nusrobomaster/Dart-FYP/docs/Introduction.md

---
title: 1 Introduction
nav_order: 1
layout: default
permalink: /overview
---

# 1.0 Introduction
### Abstract
This project aims to develop a projectile launcher and projectile to hit targets in the RoboMaster University Championship (RMUC). To do so, ASI - 403 would be building an accurate mock - up of the target for testing, implementing in-flight corrective functionality into the projectile and adjustable pitch & yaw and auto projectile reloading for the launcher. Predictive Maintenance and easy debugging & maintenance is prioritized.
## 1.1 Overview of RoboMaster University Championship (RMUC)

Founded in 2013, DJI RoboMaster University Championship (RMUC) is an annual international robotics competition organized by Da-Jiang Innovations (DJI) in China. Teams would develop different robots to perform combat on the battlefield. 

<br>
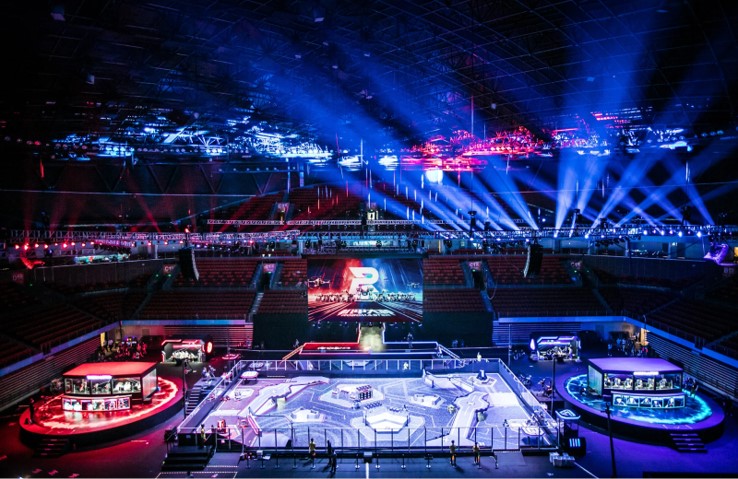
[picture p73: docs/assets/images/vj/Intro-battlefield.jpg]
Battlefield

{: .text-center}
<br>
<p align="center" class="small-text">
<em>Figure 1-1: Front view of the battlefield</em>
</p>
The goal is to launch projectiles at the pressure sensors of opponent robots and targets to defeat them.

## 1.1.1 Targets

<br>
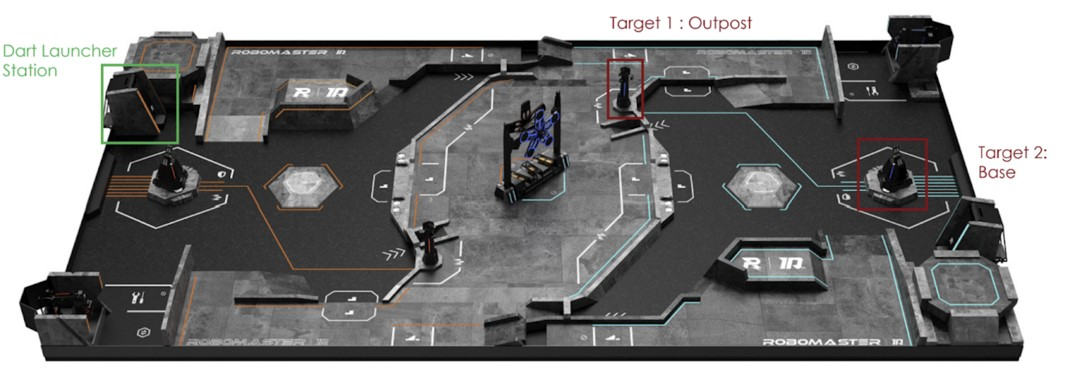
[picture p74: docs/assets/images/vj/Intro-battlefield_targets.jpg]
Battlefield Targets

{: .text-center}
<br>
<p align="center" class="small-text">
<em>Figure 1-2: Battlefield with Labelled Target Locations</em>
</p>

<br>
Target Table
{: .text-center}
<br>
<p align="center" class="small-text">
<em>Table 1-1: Target Pressor Sensor Description</em>
</p>

## 1.1.2 Winning Criteria

<br>
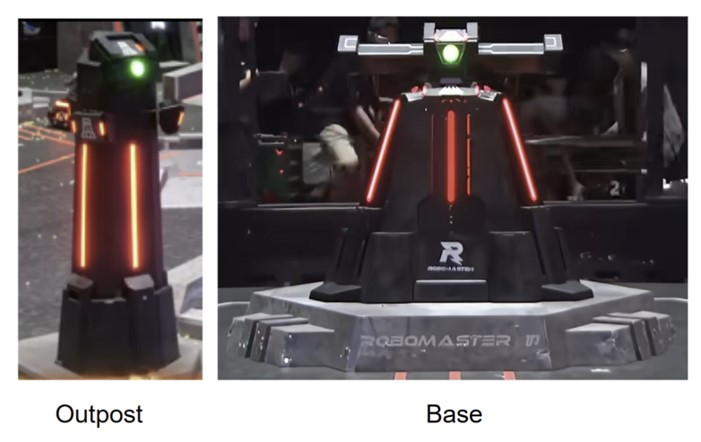
[picture p75: docs/assets/images/vj/Intro-base_outpost.jpg]
Base and outpost

{: .text-center}
<br>
<p align="center" class="small-text">
<em>Figure 1-3: Close up of Targets</em>
</p>
A team wins if the opponent's base HP reaches zero OR its base has more remaining HP than the opponent’s at the end of the match. Base is invincible until outpost is destroyed.

## 1.1.3 Armour Modules

<br>
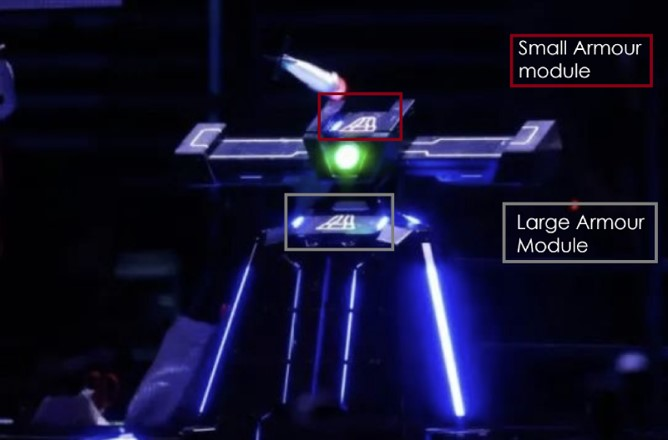
[picture p76: docs/assets/images/vj/Intro-base_armors.jpg]
Base armors

{: .text-center}
<br>
<p align="center" class="small-text">
<em>Figure 1-4: Base with Small and Large Armour Modules</em>
</p>
Most robots and targets, such as Base, use armor modules — official game system components with pressure sensors—to register hits which decreases health.

<br>
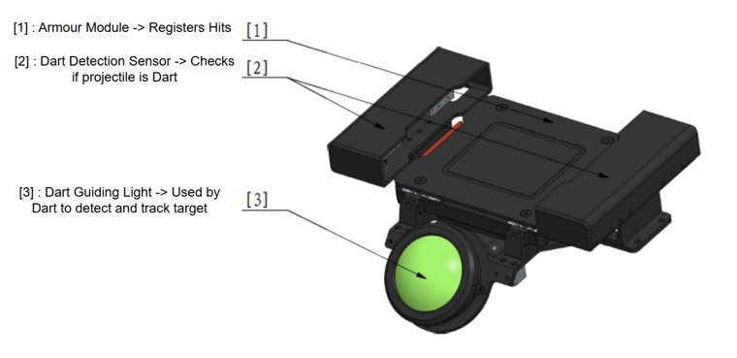
[picture p77: docs/assets/images/vj/Intro-dart_armor.jpg]
armor parts

{: .text-center}
<br>
<p align="center" class="small-text">
<em>Figure 1-5: Close up of Dart Detection Module which is on the Targets (Outpost & Base)</em>
</p>

## 1.1.4 Robot Roles

<br>
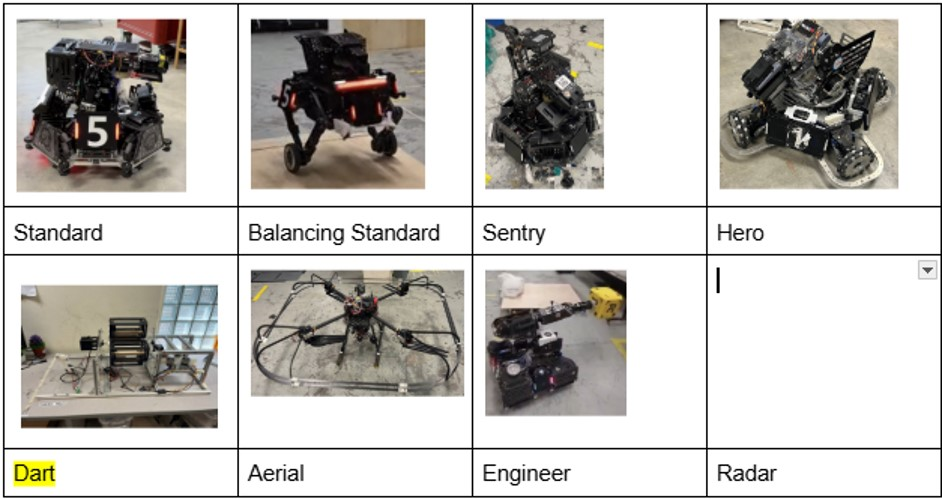
[picture p78: docs/assets/images/vj/Intro-robot_lineup_table.jpg]
Robot lineup Table

{: .text-center}
<br>
<p align="center" class="small-text">
<em>Table 1-2: The current NUS Calibur Robotics robot lineup</em>
</p>
ASI - 403 would be building a new DART robot. (See Appendix 1 for description of other robots.)

## 1.1.5 Launch Window Mechanics

<br>
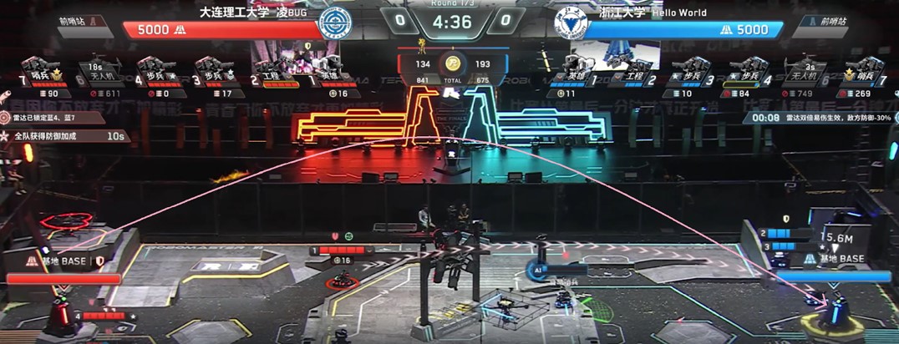
[picture p79: docs/assets/images/vj/Intro-dart_arc.jpg]
Dart flight

{: .text-center}
<br>
<p align="center" class="small-text">
<em>Figure 1-5: Example Projectile Flight Path</em>
</p>
The robot holds up to four projectiles and stays inside the Dart Launching Station with a gate that can open twice per round—once after 30 seconds and again after 4 minutes from the start of the round. Each opening lasts 20 seconds, followed by a 15-second cooldown. Unused openings can be used after the 4 minute mark. [1]

The operator selects which target (Outpost/Base) the Dart Robot aims at each opening. The team wants us to aim at base.(Strategy explained in Appendix 2)

## 1.1.6 Base Targeting Mechanics
Teams can select the desired Base target difficulty. [1]

<br>
<table>
  <tr>
    <th>Difficulty level</th>
    <th>Name of target difficulty</th>
    <th>Description</th>
  </tr>

  <!-- EASY -->
  <tr>
    <td><strong>Easy</strong></td>
    <td>
      <p align="center">
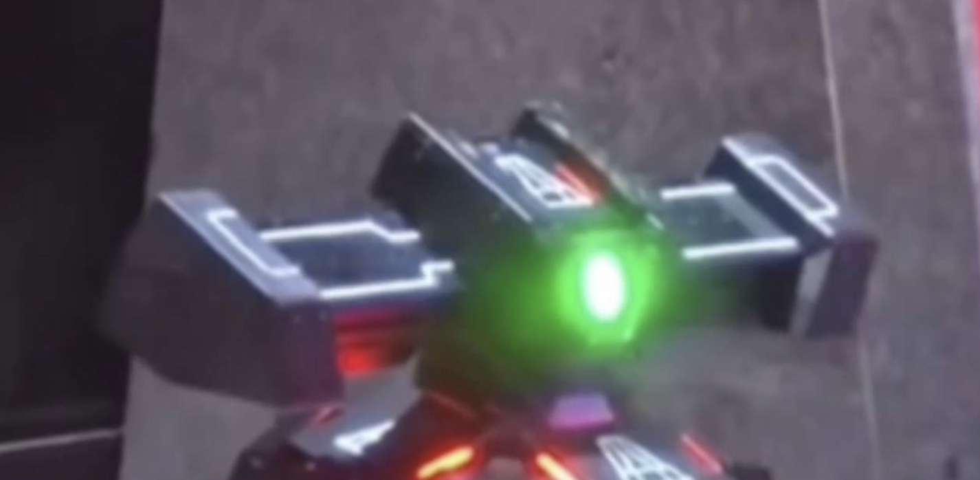
[picture p80: docs/assets/images/vj/Base_Module.png]
        
      </p>
    </td>
    <td>
      Dart Detection Module remains stationary at its initial position.
    </td>
  </tr>

  <!-- MEDIUM -->
  <tr>
    <td><strong>Medium</strong></td>
    <td>
      <iframe width="360" height="215"
      src="https://www.youtube.com/embed/zaj2007g-zE"
      title="YouTube video player"
      frameborder="0"
      allow="accelerometer; autoplay; clipboard-write; encrypted-media; gyroscope; picture-in-picture; web-share"
      allowfullscreen></iframe>
    </td>
    <td>
      Dart Detection Module shifts to a random position before the gate fully opens.
      If a dart hits the target, it moves to a new random location.
    </td>
  </tr>

  <!-- HARD -->
  <tr>
    <td><strong>Hard</strong></td>
    <td>
      <iframe width="360" height="215"
      src="https://www.youtube.com/embed/2M_oOt_SI88"
      title="YouTube video player"
      frameborder="0"
      allow="accelerometer; autoplay; clipboard-write; encrypted-media; gyroscope; picture-in-picture; web-share"
      allowfullscreen></iframe>
    </td>
    <td>
      Dart Detection Module moves continuously as the gate opens.
      After a dart is launched, it relocates within 600 ms to a new random position
      and stays stationary for up to 10 s or until the dart hits.
      Movement range: −280 mm to +280 mm along the field width.
    </td>
  </tr>

</table>

<br>
<p align="center" class="small-text">
<em>Table 1-3: Base Target Difficulty Levels</em>
</p>
Higher difficulty levels increase the damage dealt and debuffs applied to the opponent, while granting greater buffs to the attacking team upon a successful hit. (See Appendix 3 for the damage mechanisms and the buff & debuff mechanisms)

# 1.2 Past attempts’ challenges and our improvements
Since 2022, NUS Calibur Robotics has made several attempts to develop a dart robot and projectile capable of accurately hitting competition targets.
## 1.2.1 Dart Projectile
Earlier designs suffered from unstable flight due to weak aerodynamic choices (Figure 1-6a & 1-6b). This guided our new approach, which focuses on fin geometry, airflow behaviour, and roll control. The projectile will also be upgraded to an active design capable of adjusting its trajectory toward the target.

<br>
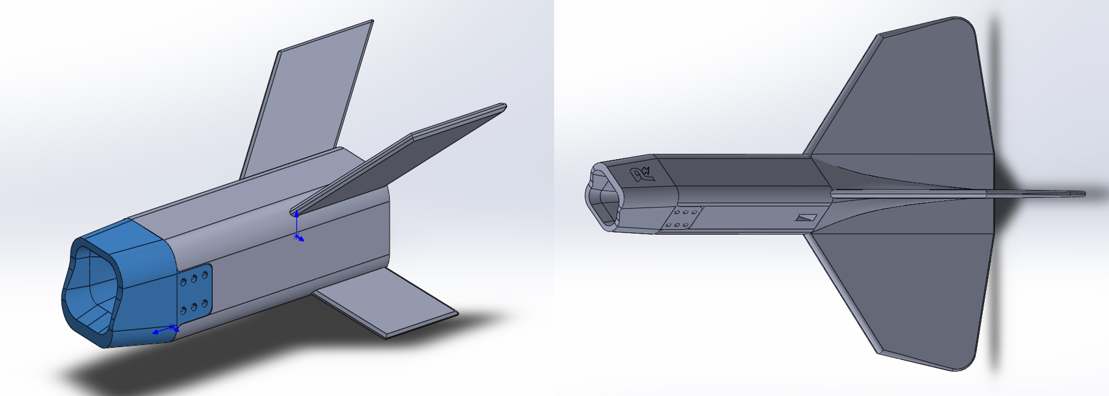
[picture p81: docs/assets/images/jianwen/Intro-past_dart_projectile.jpg]
Past Projectiles

{: .text-center}
<br>
<p align="center" class="small-text">
<em>Figure 1-6a (left) and Figure 1-6b (right): Past attempts at the dart projectile</em>
</p>

## 1.2.2 Dart Robot
Past robots showed unreliable pitch–yaw control, base instability, and inconsistent release (Figure 1-7a & 1-7b). These issues shaped the new design, which prioritizes stable actuation and a stronger frame. The flywheel launcher will be replaced with an elastic band system for more consistent release and improved accuracy.

<br>
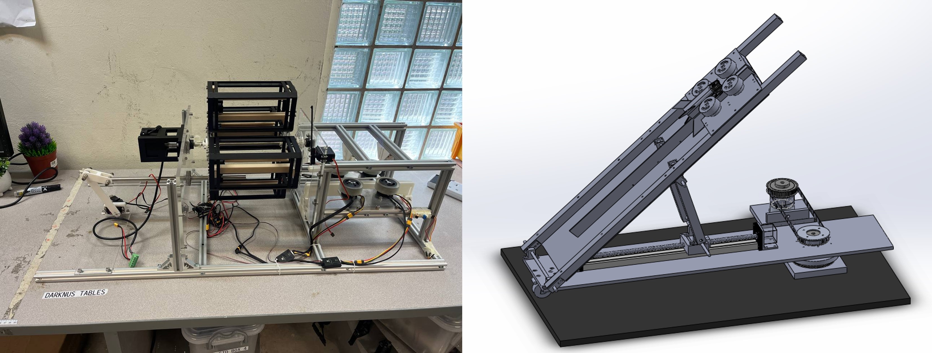
[picture p82: docs/assets/images/jianwen/Intro-past_dart_robot.jpg]
Past Robots

{: .text-center}
<br>
<p align="center" class="small-text">
<em>Figure 1-7a (left) and Figure 1-7b (right): Past attempts at the dart robot</em>
</p>

## 1.2.3 Steps forward
Insights from earlier attempts guide our integrated redesign. The projectile will be developed first, with improved aerodynamics and active-flight components. The robot will follow with reliable pitch–yaw control, a stable frame, and a simplified launch mechanism to support accurate, repeatable shots.

# 1.3 Value proposition
## 1.3.1 Stakeholders
### NUS Calibur Robotics
The goal of NUS Calibur Robotics is to compete in RMUC, which marks as a significant step up from previous years where the team only participated in the RoboMaster University League (RMUL), a smaller competition with fewer requirements. This aspiration is strongly encouraged by one of the team’s main sponsor, who views RMUC participation as an important milestone and a natural progression for NUS Calibur Robotics. With the discontinuation of the affiliation between RMUL and DJI, the motivation to advance to RMUC has become even stronger. Although the dart system is not a mandatory requirement for entry, its absence was one of the key factors that limited the team’s eligibility for RMUC 2025. As eligibility is bell-curved across all teams, producing a functional dart prototype by March next year is therefore crucial to demonstrate the team’s technical capability and readiness for RMUC qualification.
### Robomaster Organization Community (DJI RMOC) 
The RoboMaster Organizing Committee (RMOC), founded by DJI, is the governing body that oversees the RoboMaster competitions. RMOC establishes and updates the rule manual, building specifications, and technical assessment criteria for all participating teams to ensure fair, transparent, and competitive gameplay. The rule manual outlines the competition gameplay, including game objectives, field layout, and damage scoring. While the building specifications provide guidelines for robot design, setting limits on dimensions, weight, and power. Lastly, the assessment criteria is used to filter for teams with the best technical competency.
## 1.3.2 Value Proposition Canvas
With the stakeholders identified and NUS calibur robotics chosen as our main stakeholder, a value proposition canvas was done below in Figure 1-8.

<br>
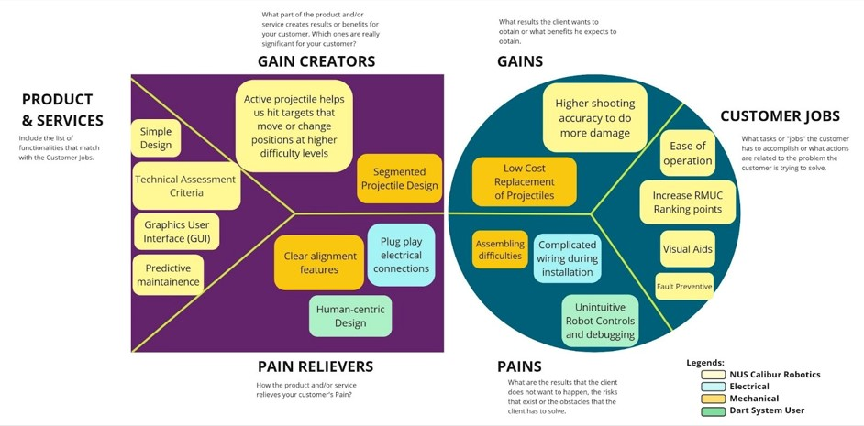
[picture p83: docs/assets/images/barry/Intro-value_prop.jpg]
Value prop canvas

{: .text-center}
<br>
<p align="center" class="small-text">
<em>Figure 1-8: Value Proposition Canvas</em>
</p>
After drafting the value proposition canvas, our value proposition statement is formulated from the value proposition canvas.

## 1.3.3 Value Proposition Statement
Our team aims to help **NUS Calibur Robotics** build a simple and accurate dart system through clear alignment features with plug-and-play electrical connections and active projectiles able to hit the target at all difficulty levels.

This dart system will also be competition-ready, which is to comply with the rules and regulations set by the **RMOC**.

The dart system will abide by the technical assessment criteria set by **RMOC** and provide **NUS Calibur Robotics** with additional ranking points.

# 1.4 DESIGN SPECIFICATION
We have two key stakeholders with different requirements that our DART project will have to satisfy, DJI RMOC committee who organise this competition and set the rules and regulations, and NUS Calibur Robotics who will be using our Dart Robot in its entirety after our project ends. Firstly, from the Robomaster Organization Community (DJI RMOC) standpoint, here are the requirements:

## RMOC Standpoint Requirements:
## 1.4.1 Arena Setup

<br>
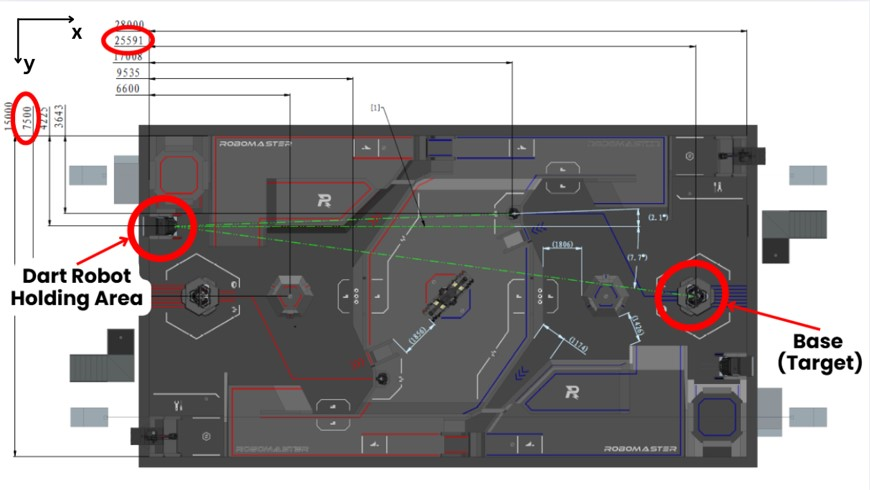
[picture p84: docs/assets/images/shyam/Intro-targets1.jpg]
Map target 1

{: .text-center}
<br>
<br>
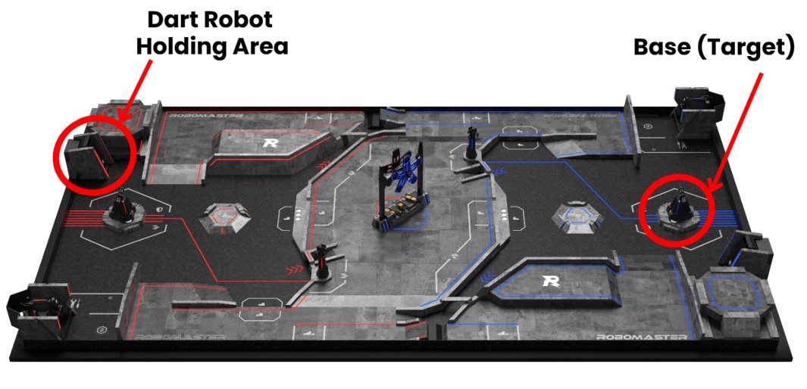
[picture p85: docs/assets/images/shyam/Intro-targets2.jpg]
Map target 2

{: .text-center}
<br>
<p align="center" class="small-text">
<em>Figure 1-9 & 1-10: Complete Arena Setup with dimensions specified</em>
</p>

1. The backend of the Dart System will be positioned exactly x-distance 25591mm away from the target, and has to turn 7.7 degrees to the right in order to align with the center mark of the target plate. The y-distance is exactly 3275mm. 

<br>
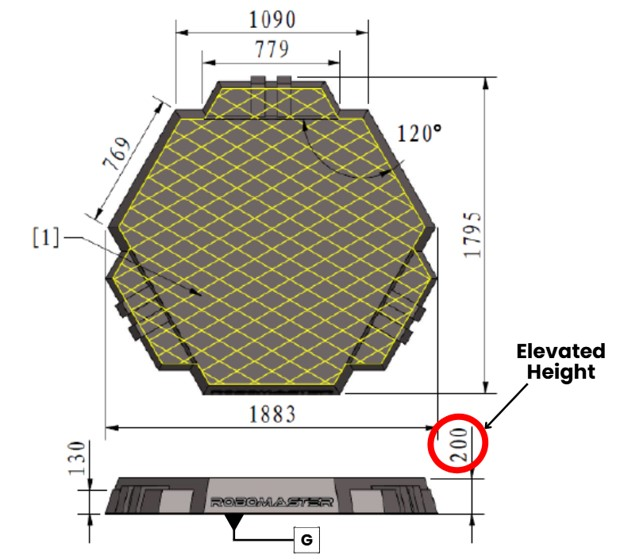
[picture p86: docs/assets/images/shyam/Intro-platform_specs.jpg]
Platform specs

{: .text-center}
<br>
<p align="center" class="small-text">
<em>Figure 1-11: Base Target structure’s platform</em>
</p>

2. The entire base target structure sits on a platform that is elevated off common ground by 200mm. This key information is vital to add to the dimensions highlighted in Figure 1-12, and these values are key for the launcher calculations in accurately hitting the target.

<br>
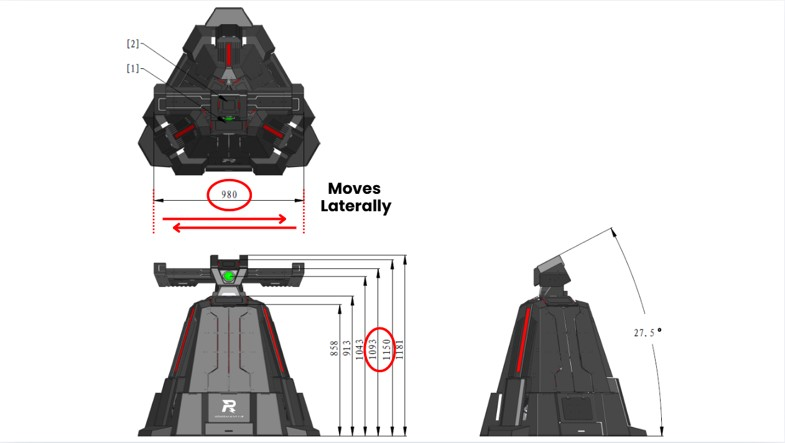
[picture p87: docs/assets/images/shyam/Intro-base_specs.jpg]
Base Specs

{: .text-center}
<br>
<p align="center" class="small-text">
<em>Figure 1-12 & 1-13: Base Target Structure </em>
</p>

3. The target plate is able to move laterally a distance of 980mm. Target is a small armour plate (square shape, 140mmx140mm) tilted 27.5 degrees from the horizontal plane. ***From a vertical standpoint***, the allowable range for a successful hit is y∈{1293mm,1350mm}. For accuracy, let us aim for bullseye, **y=1321.5mm**.

<br>
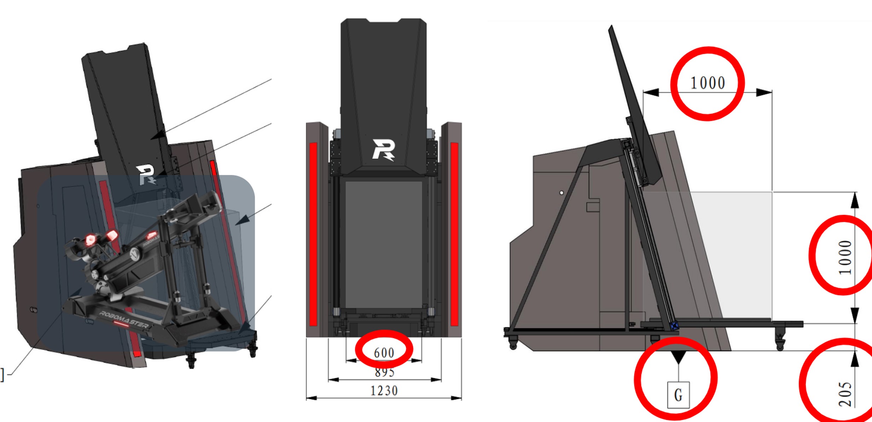
[picture p88: docs/assets/images/shyam/Intro-gate_specs.jpg]
gate specs

{: .text-center}
<br>
<p align="center" class="small-text">
<em>Figure 1-14: Dart Robot Holding Station</em>
</p>

4. The Dart Robot will be placed inside the Dart Robot Holding Station shown in Figure 1-14 prior to the match, and hence must abide by the Size restriction 1000mmx600mmx1000mm (LxBxH).Keep in mind the dart system is placed on the sliding platform that is 205mm elevated from common ground.

## 1.4.2 ROBOT BUILDING SETUP

**Dart System Regulations:**
The Dart Robot consists of the Yaw, Pitch, Launcher and Feeder. The Launcher and Feeder combined can hold *no more than 4 projectiles* prior to the match, and it *may or have ONE projectile pre-loaded before the match*. The Dart Robot serves as the carrier of projectiles and provides them with initial propulsion.

<br>
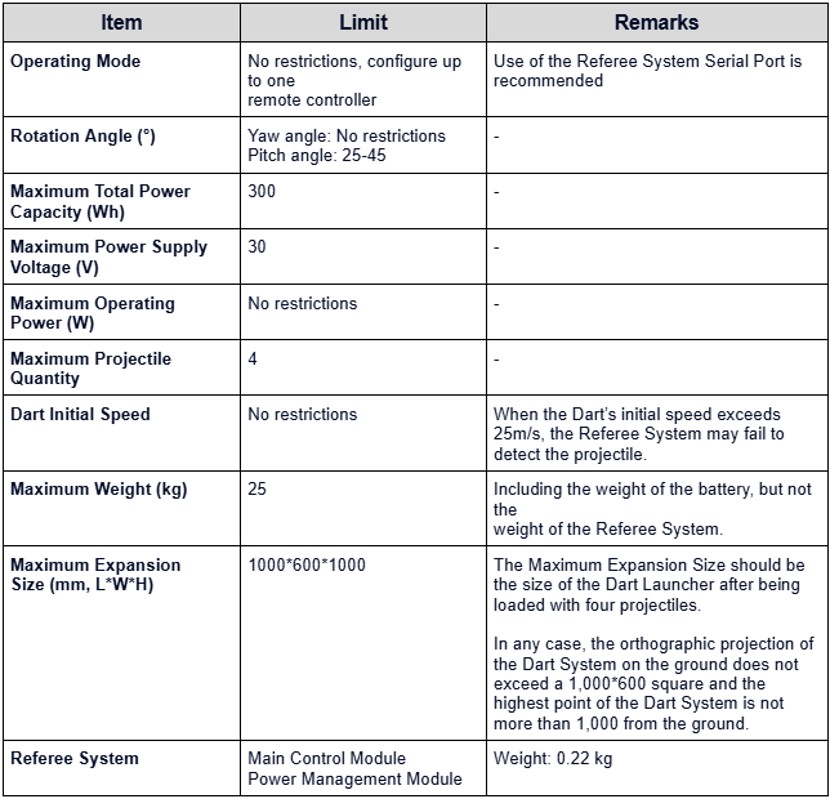
[picture p89: docs/assets/images/shyam/Intro-robot_specs_table.jpg]
dart robot specs table

{: .text-center}
<br>
<p align="center" class="small-text">
<em>Table 1-4: Dart System Production Parameters</em>
</p>

**Projectile Regulations:**

<br>
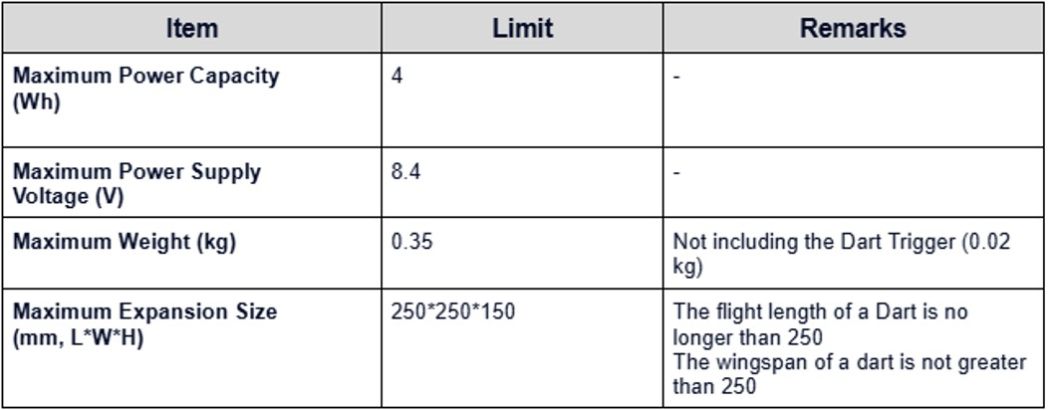
[picture p90: docs/assets/images/shyam/Intro-dart_proj_specs_table.jpg]
projectile specs table

{: .text-center}
<br>
<p align="center" class="small-text">
<em>Table 1-5: Projectile Production Parameters</em>
</p>

<br>
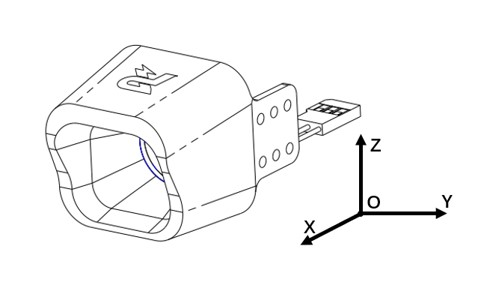
[picture p91: docs/assets/images/shyam/Intro-proj_head.jpg]
dart trigger

{: .text-center}
<br>
<p align="center" class="small-text">
<em>Figure 1-15: Mandatory Dart Trigger at the head of projectile</em>
</p>

The Dart Trigger designated by the RMOC will be mounted on our custom Projectile. This is a competition requirement and cannot be changed or modified. The Dart Trigger is a cream-white translucent shell made of TPU, with a mass of 20 g. Its external form is shown above.

After the Dart Trigger is mounted, ensure its top, bottom, left, and right sides are not blocked by the projectile structure. Within a hemisphere of a 125 mm radius centered on the central point of the bottom surface of the Dart Trigger, there must be no blockage, as shown in the figure below.

<br>
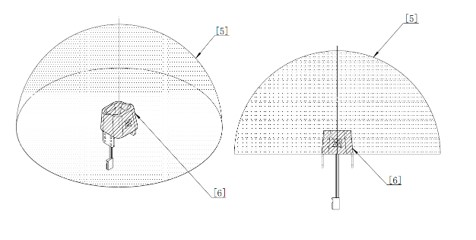
[picture p92: docs/assets/images/shyam/Intro-proj_head_restrict.jpg]
dart trigger restrictions

{: .text-center}
<br>
<p align="center" class="small-text">
<em>Figure 1-16: Dart Projectile Rules regarding Dart Trigger (no blockage surrounding dart trigger) </em>
</p>
Dart cameras or other devices can be mounted in the internal cavity of Dart Trigger. The mounting area shall not exceed the shadow area, as shown below.

<br>
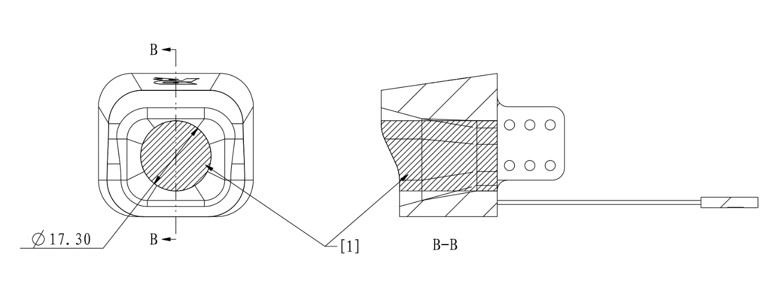
[picture p93: docs/assets/images/shyam/Intro-proj_head_specs.jpg]
dart trigger specs

{: .text-center}
<br>
<p align="center" class="small-text">
<em>Figure 1-17: Dart Projectile Rules regarding Dart Trigger (usage of inner hollow space)</em>
</p>

## 1.5 Design Approach

<br>
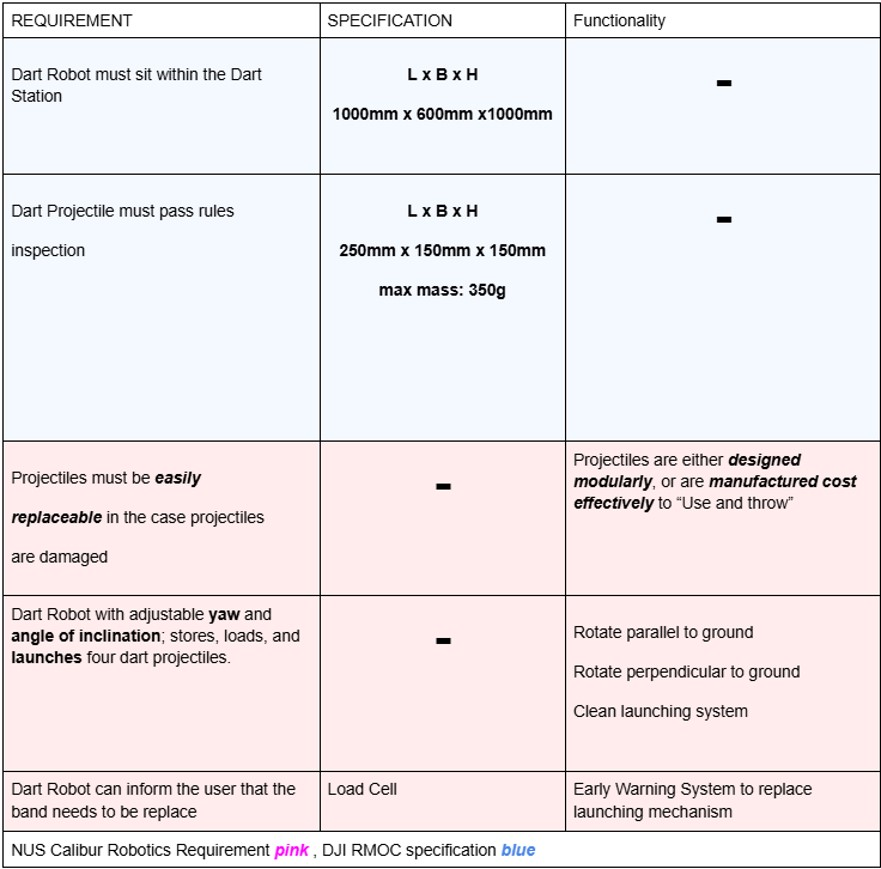
[picture p94: docs/assets/images/shyam/Intro-functionality_table.jpg]
functionality table

{: .text-center}
<br>
<p align="center" class="small-text">
<em>Table 1-6: Functionality Table of entire Dart Robot</em>
</p>
Our team has compiled both the requirements from NUS Calibur Robotics and DJI RMOC’s rules and have formatted them into a functionality table in Table 1-6. This table clearly pins down the requirements into their respective specifications that we will have to adhere to, and more importantly the Functionalities we will have to deliver.
