nusrobomaster/Dart-FYP/docs/References.md

---
title: 11 References
nav_order: 99
layout: default
permalink: /References
---

<!-- Short overview of the projectile here -->

### References

| Ref | Full IEEE Reference |
|-----|---|
| **[1]** | RoboMaster Organizing Committee, *RoboMaster 2025 University Championship Rules Manual*, Version 2.0.0, July. 3, 2025. |
| **[2]** | “Complete Guide to LiPo Battery Voltage,” Ufine Battery [Official], 2024.|
| **[3]** | RoboticsTomorrow, “Optimizing Servo System Performance: A Comprehensive Guide to Eliminating Electrical Noise and Enhancing Noise Immunity” Roboticstomorrow.com, 2024.|
| **[4]** | L. OpenMV, “Creating threshold for color blob tracking,” OpenMV Forums, May 26, 2018. (accessed Nov. 16, 2025). |
| **[5]** | RoboMaster Organizing Committee, *Robot Building Specifications Manual*, Version 1.2.0, Apr. 9, 2025. |
| **[6]** | DJI, *RoboMaster Development Board User Manual*, Access PDF, 2025. |

‌
