nusrobomaster/Dart-FYP/docs/Z Dart Robot.md

---
title: Dart Robot
parent: Dart System
has_children: true
nav_order: 2
layout: default
permalink: /dart-system/dart-robot
has_toc: false
---

<!-- overview of the dart robot -->
# Dart Robot Section

<br>
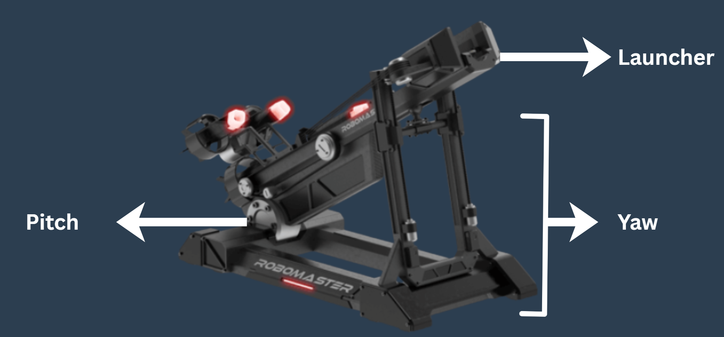
[picture p143: docs/assets/images/shyam/pyl.png]
pyl

{: .text-center}
<br>
<p align="center" class="small-text">
<em>3D rendering of Yaw, Pitch and Launcher</em>
</p>

<h3> Mechanical - Dart Robot </h3>
<h3>
<a href="{{ '/dart-system/dart-robot/yaw' | relative_url }}">Yaw</a><br>
<a href="{{ '/dart-system/dart-robot/pitch' | relative_url }}">Pitch</a><br>
<a href="{{ '/dart-system/dart-robot/launcher' | relative_url }}">Launcher</a>
</h3>
This section lists the mechanical subsystems of the Dart Robot: Yaw, Pitch, and Launcher.

<h3>
<a href="{{ '/dart-system/dart-robot/elec-software' | relative_url }}">Electrical & Software - Dart Robot</a>
</h3>
This section lists the electrical and software work of the Dart Robot, covering sensing, control logic, and actuation.
