nusrobomaster/Dart-FYP/docs/Project Plan.md

---
title: 9 Project Plan
nav_order: 4
layout: default
permalink: /project_plan
---

# Project Plan
The Gantt chart in Figure 9-1 outlines the subsystem tasks from 4 August 2025 to 31 July 2026. Key milestones are marked with red boxes and a red star. The main milestone is the handover of the robot to the competition team, followed by the competition date two months later. 

<br>
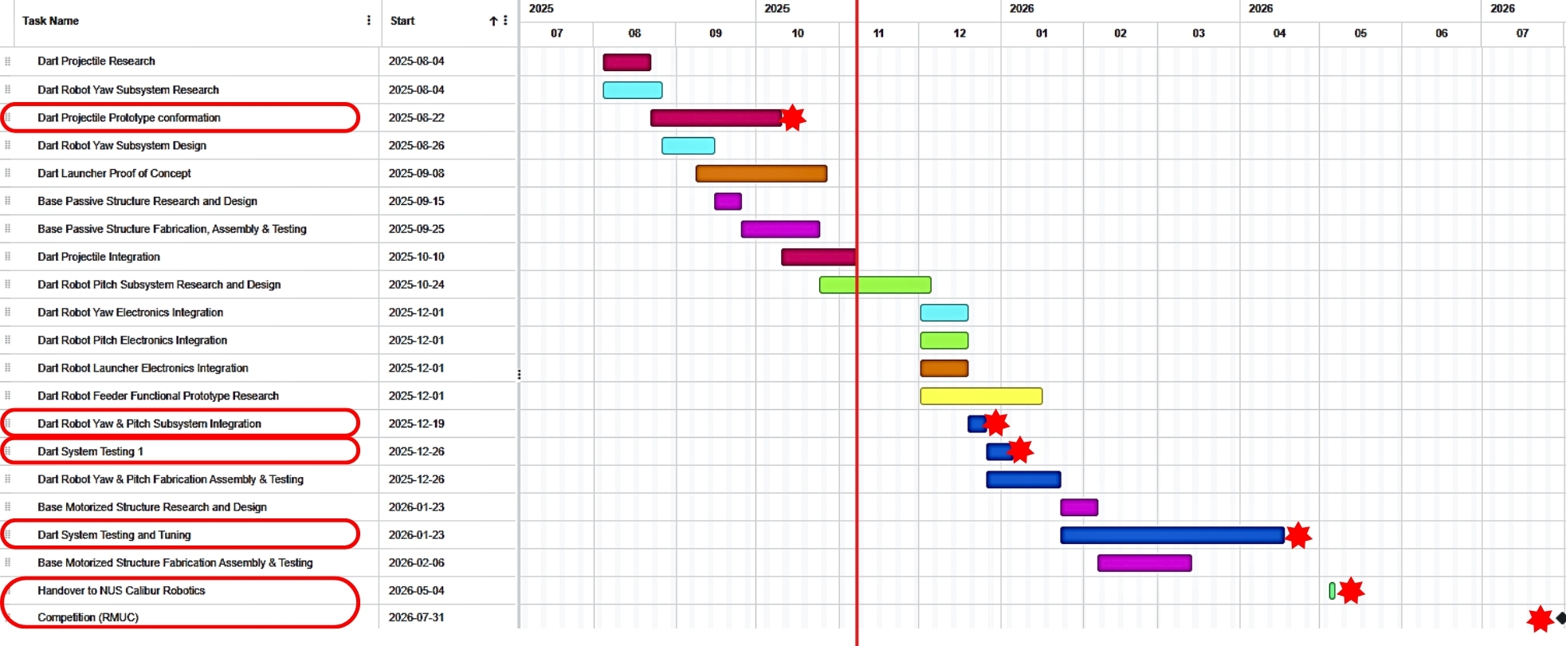
[picture p144: docs/assets/images/jianwen/Project_plan-gantt.jpg]
gantt chart

{: .text-center}
<br>
<p align="center" class="small-text">
<em>Figure 9-1: Gantt Chart detailing project activities</em>
</p>
