nusrobomaster/Dart-FYP/docs/Z Dart System.md

---
title: Dart System
nav_order: 2        # between Introduction (1) and Base Structure (3/4)
has_children: true
layout: default
permalink: /dart-system
has_toc: false
---

<!-- intro text -->
# Our Robot Subsystems
From the functionality table, we derived the following subsystems labelled in the rendering below.

<br>
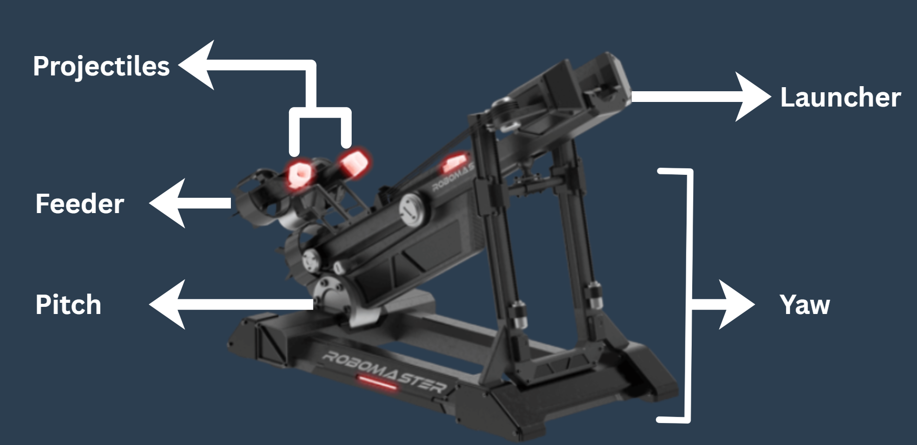
[picture p145: docs/assets/images/shyam/robotsubdiv.png]
full dart subsys

{: .text-center}
<br>
<p align="center" class="small-text">
<em>A 3D rendering of a Dart Robot designed by RMOC.</em>
</p>

# The Team

Below are the personnel in our project team, and the breakdown of responsibilities for each subsystem.

<div class="team-grid">

  <div class="team-card">
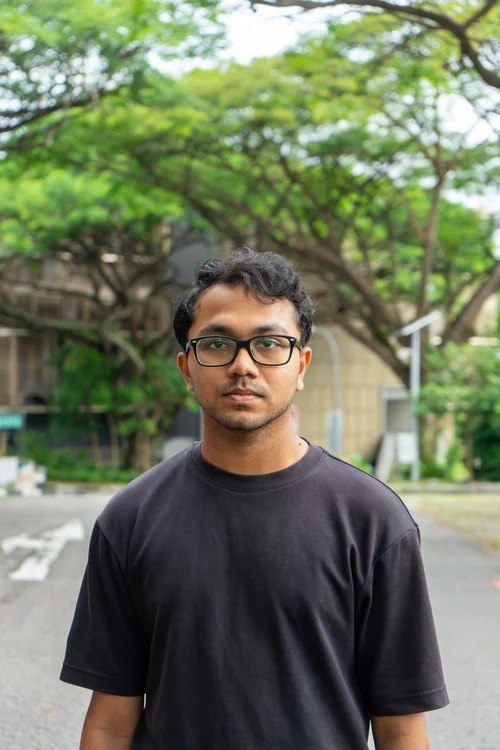
[picture p146: docs/assets/images/portraits/VJ-portrait.jpg]
VJ
    
    <p class="team-meta">VJ<br>A0261513N<br>Electrical</p>
    <p class="team-name">
      <a href="{{ '/dart-system/projectile/elec-software' | relative_url }}">Projectile - Electrical & Software</a><br>
      <a href="{{ '/base_structure' | relative_url }}">Base Structure</a>
    </p>
  </div>

  <div class="team-card">
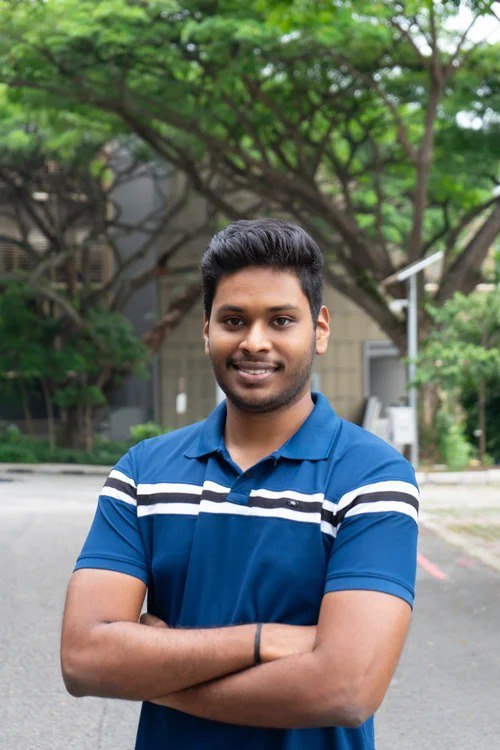
[picture p147: docs/assets/images/portraits/Shyam-portrait.jpg]
Shyam
    
    <p class="team-meta">Shyam<br>A0251760J<br>Mechanical</p>
    <p class="team-name">
      <a href="{{ '/dart-system/projectile/mechanical' | relative_url }}">Projectile - Mechanical Design</a><br>
      <a href="{{ '/dart-system/dart-robot/launcher' | relative_url }}">Launcher - Mechanical Design</a>
    </p>
  </div>

  <div class="team-card">
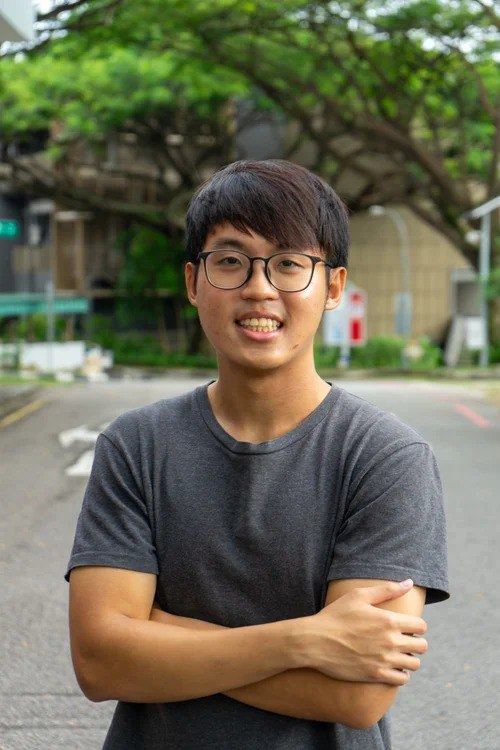
[picture p148: docs/assets/images/portraits/Barry-portrait.jpg]
Barry
    
    <p class="team-meta">Barry<br>A0258254Y<br>Electrical</p>
    <p class="team-name">
      <a href="{{ '/dart-system/dart-robot/elec-software' | relative_url }}">Dart Robot - Electrical & Software</a>
    </p>
  </div>

  <div class="team-card">
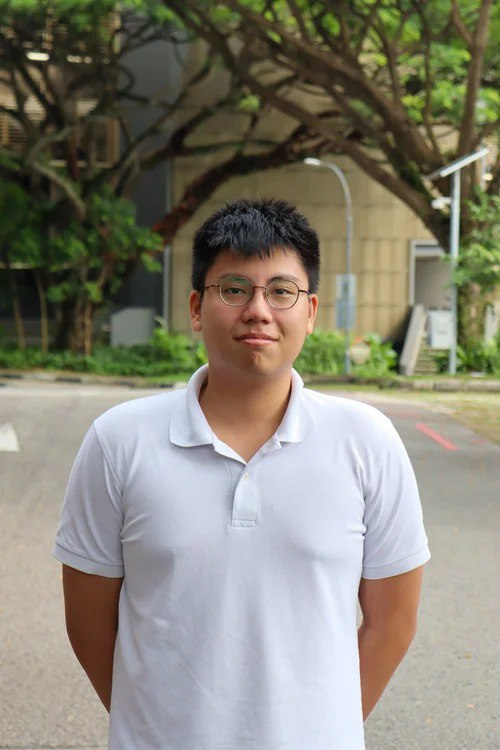
[picture p149: docs/assets/images/portraits/Jianwen-portrait.jpg]
Jian Wen
    
    <p class="team-meta">Jian Wen<br>A0252100E<br>Mechanical</p>
    <p class="team-name">
      <a href="{{ '/dart-system/dart-robot/yaw' | relative_url }}">Yaw - Mechanical Design</a><br>
      <a href="{{ '/dart-system/dart-robot/pitch' | relative_url }}">Pitch - Mechanical Design</a><br>
      <a href="{{ '/base_structure' | relative_url }}">Base Structure</a>
    </p>
  </div>

</div>
