nusrobomaster/Dart-FYP/docs/Z Projectile.md

---
title: Projectile
parent: Dart System
has_children: true
nav_order: 1
layout: default
permalink: /dart-system/projectile
has_toc: false
---

<!-- Short overview of the projectile here -->
# Dart Projectile Section

<br>
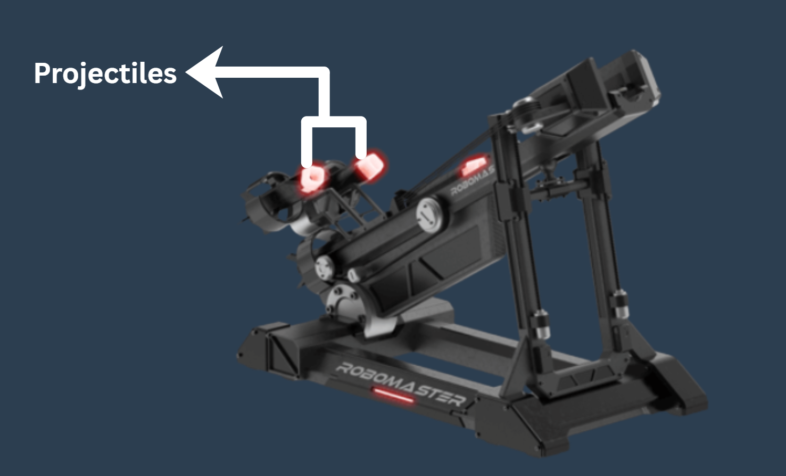
[picture p150: docs/assets/images/shyam/ponly.png]
ponly

{: .text-center}
<br>
<p align="center" class="small-text">
<em>3D rendering showing the Projectiles</em>
</p>

<h3>
<a href="{{ '/dart-system/projectile/mechanical' | relative_url }}">Mechanical - Projectile</a>
</h3>

This section lists the mechanical aspects of the Projectile, such as structure, aerodynamics, and testing.

<h3>
<a href="{{ '/dart-system/projectile/elec-software' | relative_url }}">Electrical & Software - Projectile</a>
</h3>

This section lists the electrical work related to the Projectile, including sensors, triggering, and data capture.
