nusrobomaster/Dart-FYP/docs/index.md

---
layout: default
title: Home
nav_order: 0
nav_exclude: true
---
<!-- useless fking page<-->
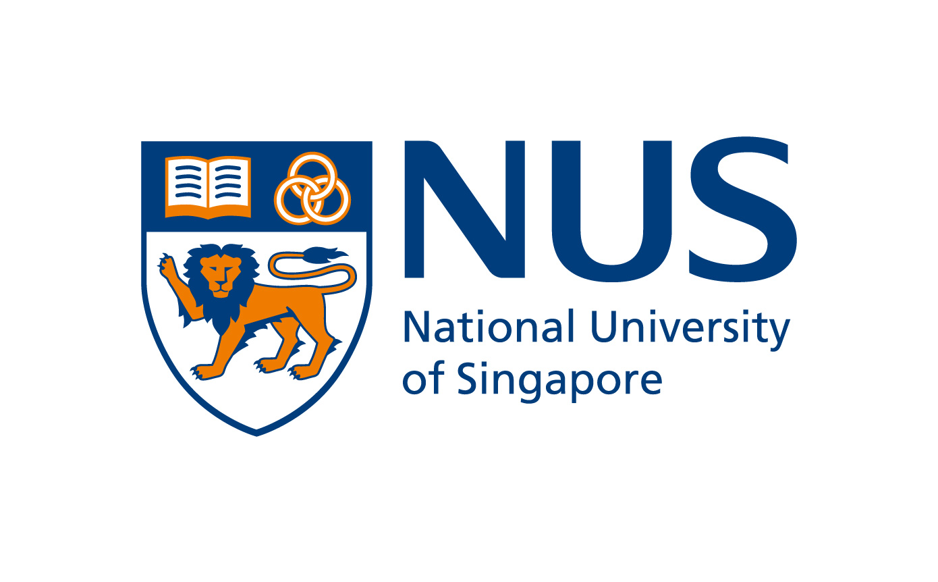
[picture p151: docs/assets/images/portraits/NUS_Logo.jpg]
NUS Logo

{: .text-center}
<br>

<h2 align="center"> CDE 4301: ASI-403 Dart Project Interim Report </h2>
<h2 align="center"> To Begin, Click on 1 Introduction from the Navigation Bar on your left </h2>
