nusrobomaster/Dart-FYP/docs/Dart Robot Subsystems.md

---
title: Dart Robot Subsystems
has_children: true
nav_order: 2
layout: default
permalink: /dart_robot_subsystems
has_toc: true
nav_exclude: true
---
# The Team

Below is the breakdown of responsibilities for each subsystem.

<div class="team-grid">

  <div class="team-card">
    VJ
    <p class="team-meta">VJ<br>A0261513N<br>Electrical</p>
    <p class="team-name">
      <a href="{{ '/projectile/elec&software' | relative_url }}">Projectile - Electrical & Software</a><br>
      <a href="{{ '/base_structure' | relative_url }}">Base Structure</a>
    </p>
  </div>

  <div class="team-card">
    Shyam
    <p class="team-meta">Shyam<br>A0251760J<br>Mechanical</p>
    <p class="team-name">
      <a href="{{ '/projectile/mech_design' | relative_url }}">Projectile - Mechanical Design</a><br>
      <a href="{{ '/launcher/mech_design' | relative_url }}">Launcher - Mechanical Design</a>
    </p>
  </div>

  <div class="team-card">
    Barry
    <p class="team-meta">Barry<br>A0258254Y<br>Electrical</p>
    <p class="team-name">
      <a href="{{ '/launcher/elec&software' | relative_url }}">Launcher - Electrical & Software</a>
    </p>
  </div>

  <div class="team-card">
    Jian Wen
    <p class="team-meta">Jian Wen<br>A0252100E<br>Mechanical</p>
    <p class="team-name">
      <a href="{{ '/yaw' | relative_url }}">Yaw - Mechanical Design</a><br>
      <a href="{{ '/pitch' | relative_url }}">Pitch - Mechanical Design</a><br>
      <a href="{{ '/base_structure' | relative_url }}">Base Structure</a>
    </p>
  </div>

</div>
