nusrobomaster/Dart-FYP/docs/assets/images/barry/GUI_Library_Comparison.png

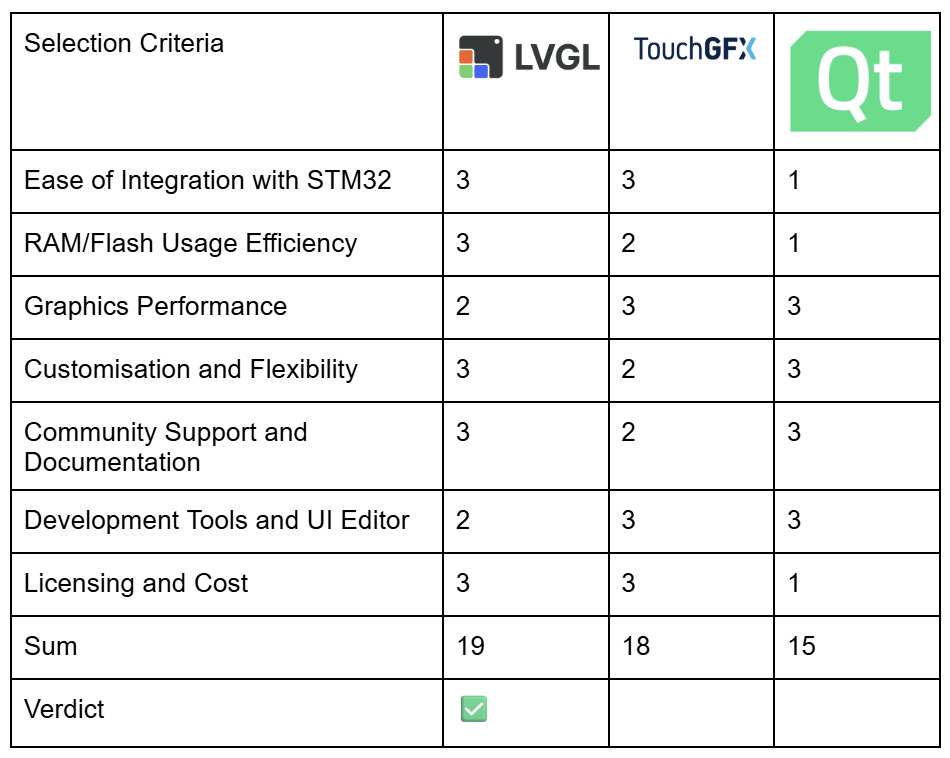
docs/assets/images/barry/GUI_Library_Comparison.png
