nusrobomaster/Dart-FYP/docs/assets/images/barry/Touch_Screen_Comparison.png

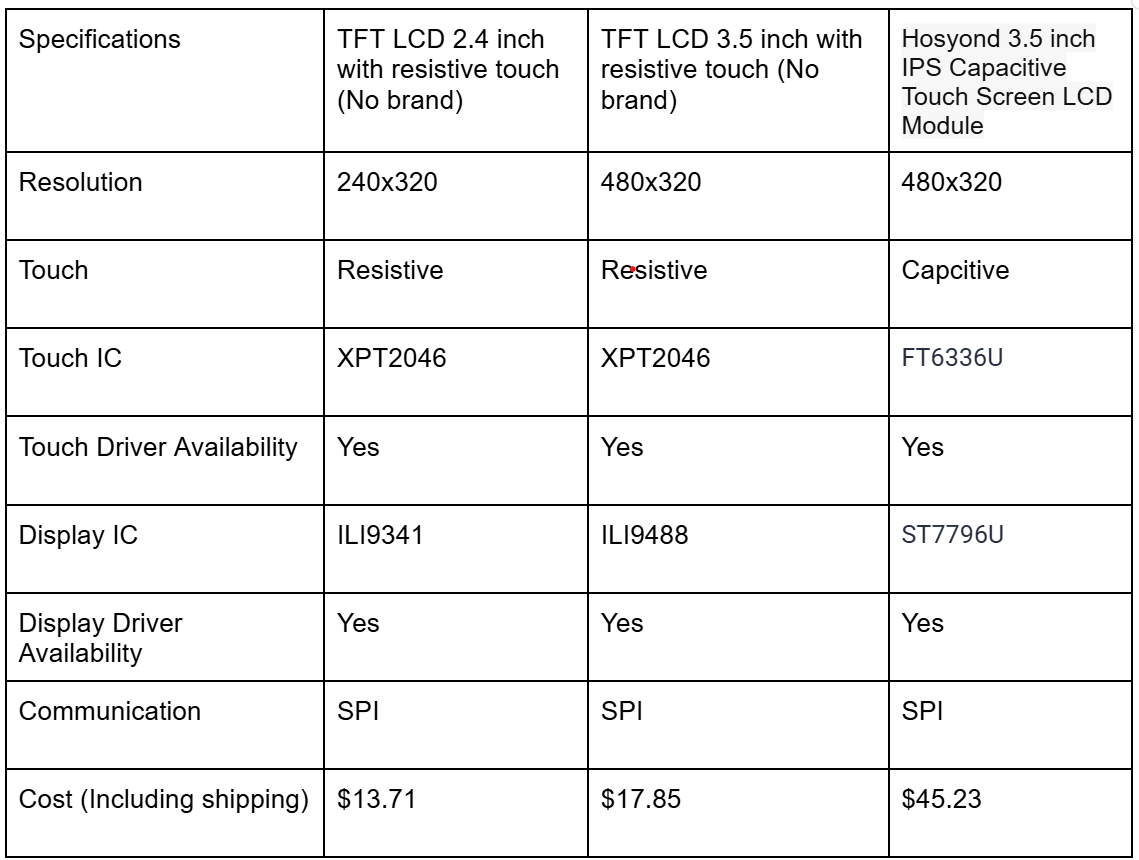
docs/assets/images/barry/Touch_Screen_Comparison.png
