nusrobomaster/Dart-FYP/docs/assets/images/shyam/compression.png

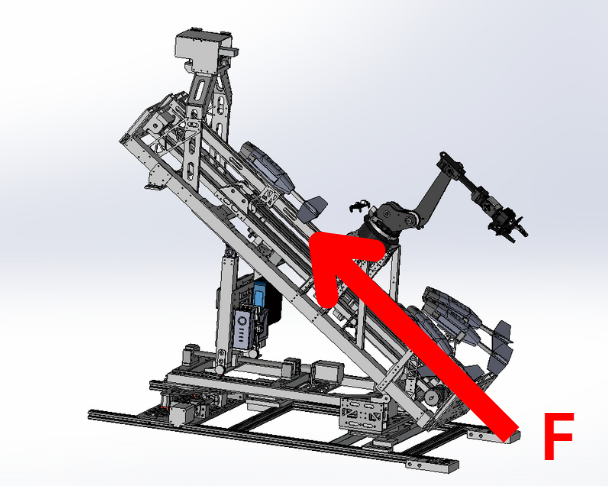
docs/assets/images/shyam/compression.png
