nusrobomaster/Dart-FYP/docs/assets/images/shyam/Intro-armor_specs.jpg

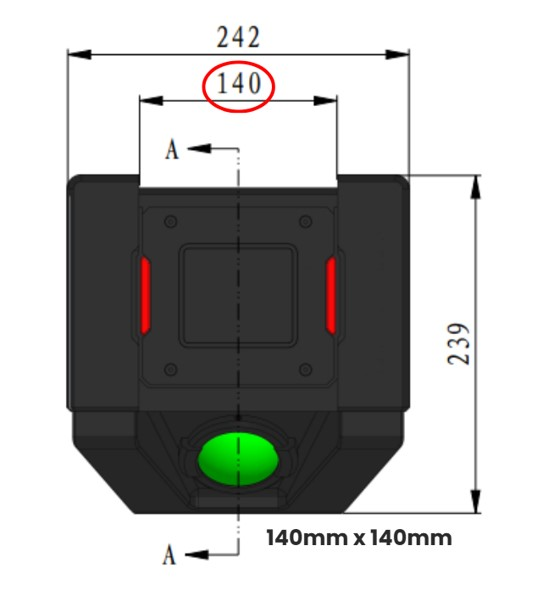
docs/assets/images/shyam/Intro-armor_specs.jpg
