nusrobomaster/Dart-FYP/docs/assets/images/shyam/launcherreal.png

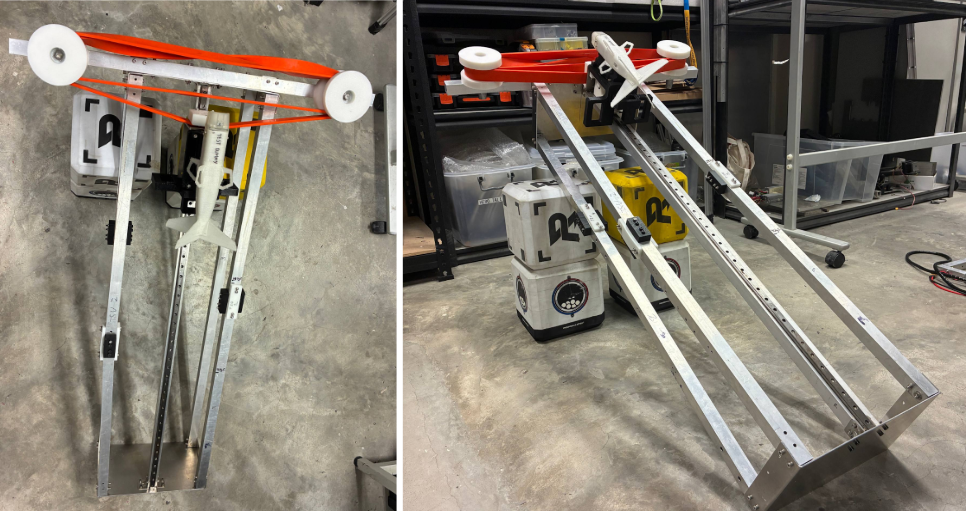
docs/assets/images/shyam/launcherreal.png
