nusrobomaster/Dart-FYP/docs/assets/images/shyam/spring.png

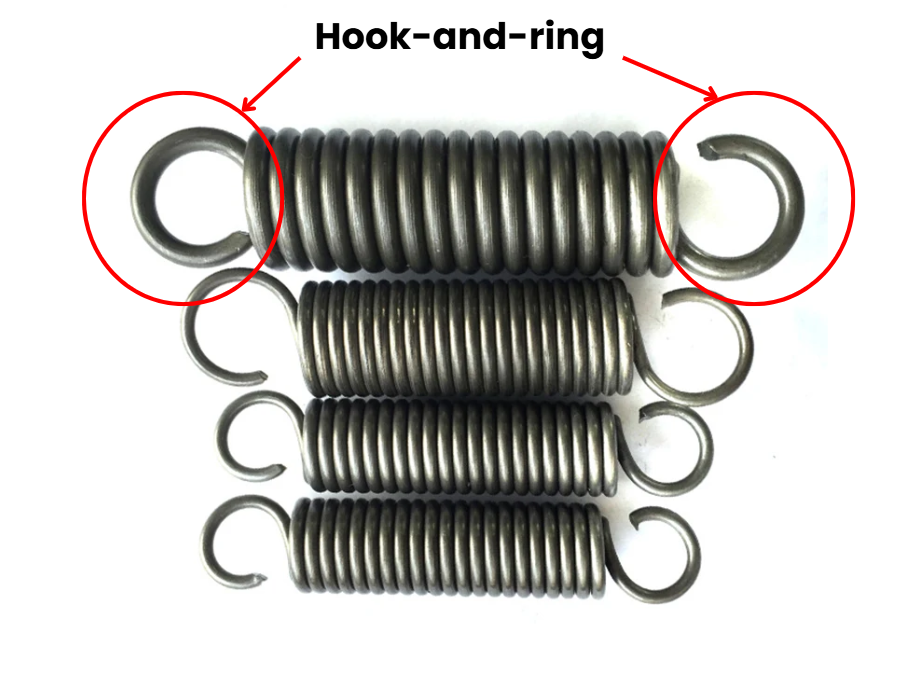
docs/assets/images/shyam/spring.png
