nusrobomaster/Dart-FYP/docs/assets/images/shyam/tension.png

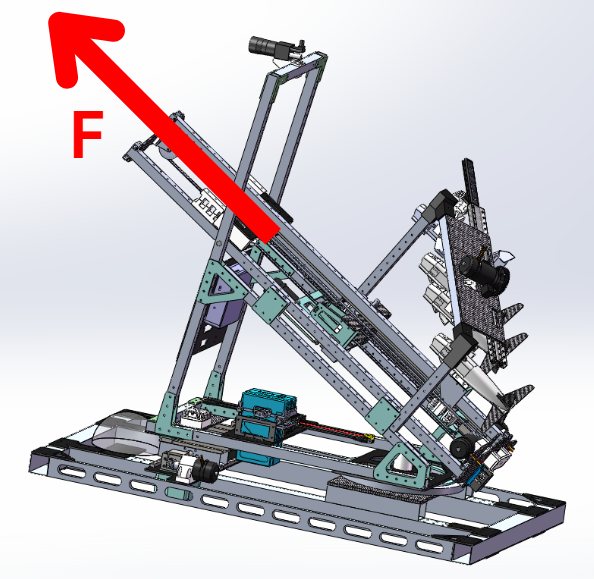
docs/assets/images/shyam/tension.png
