nusrobomaster/Dart-FYP/docs/assets/images/vj/Base/Comparisons_of_the_Light_Temperature_between_NO_FAN_and_WITH_FAN_conditions.png

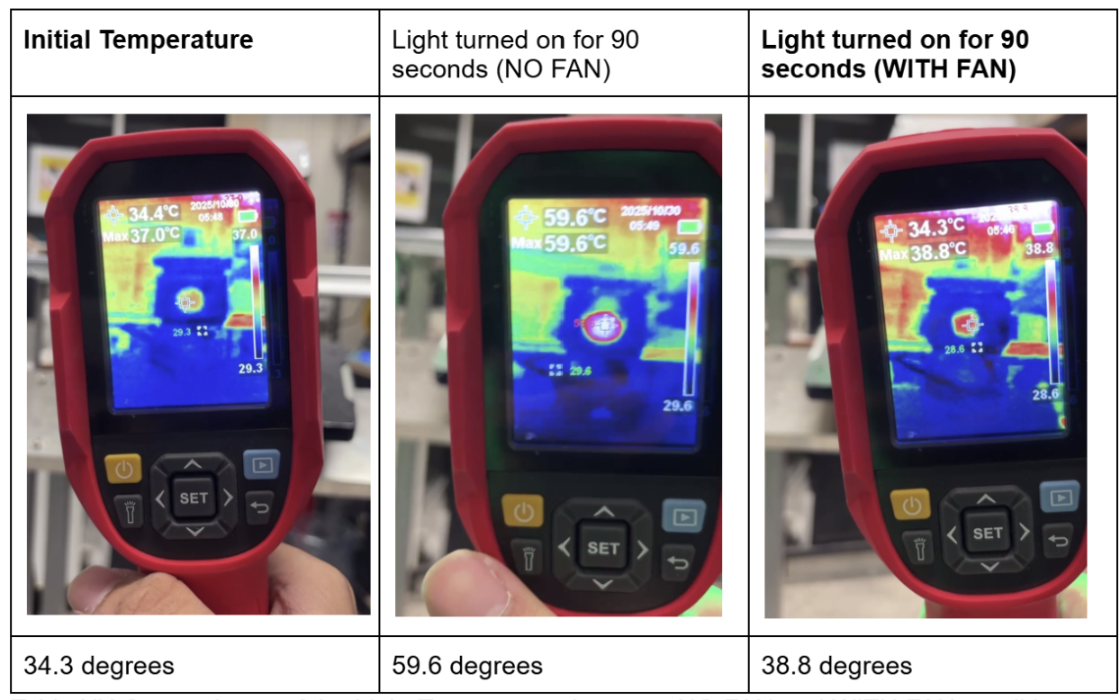
docs/assets/images/vj/Base/Comparisons_of_the_Light_Temperature_between_NO_FAN_and_WITH_FAN_conditions.png
