nusrobomaster/Dart-FYP/docs/assets/images/vj/Intro-difficulties.jpg

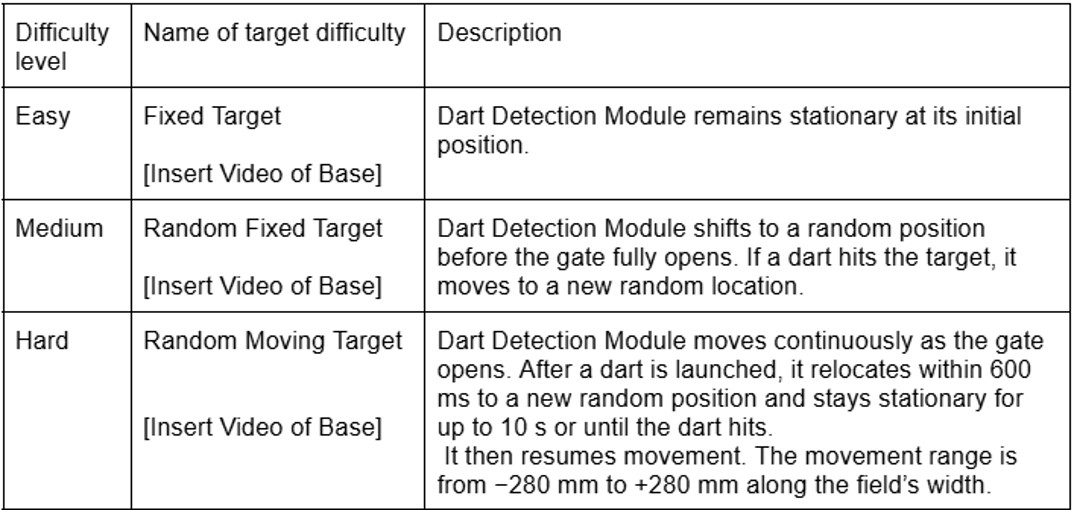
docs/assets/images/vj/Intro-difficulties.jpg
