nusrobomaster/Dart-FYP/Implement_pitch_yaw_feeder/Core/Src/Tasks/task_state_machines.png

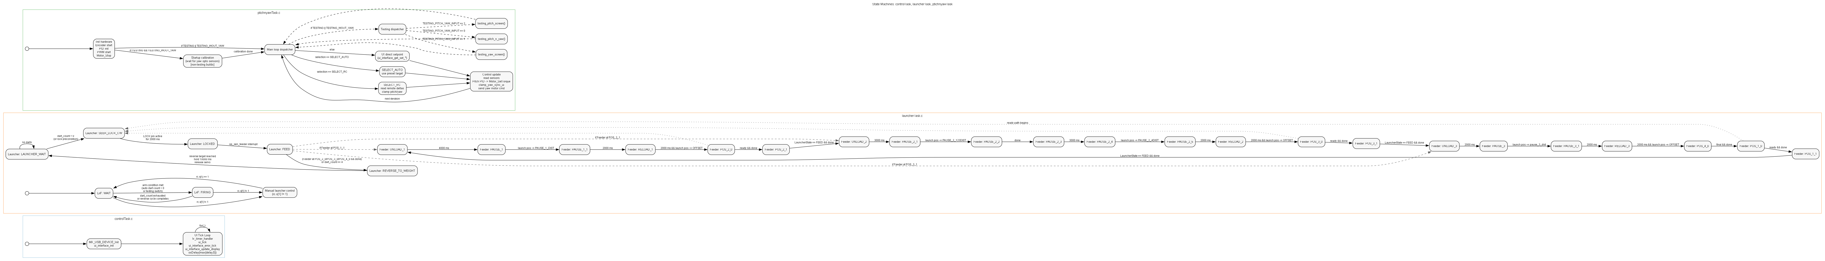
Implement_pitch_yaw_feeder/Core/Src/Tasks/task_state_machines.png
