nusrobomaster/Dart-FYP/kicad_files/Dart_launcher_robot_pcb/Dart_launcher_robot_pcb.step

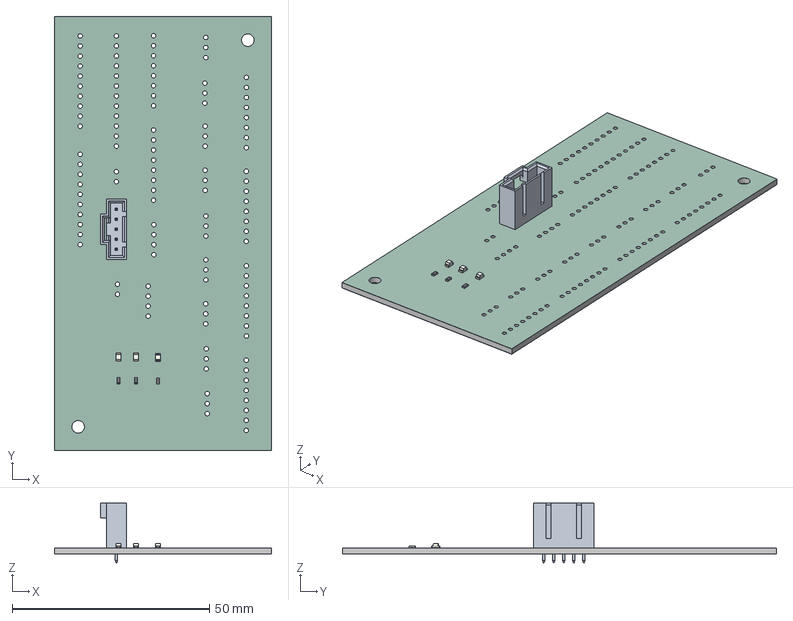
[picture p165: CAD file, 2026-03-05]
kicad_files/Dart_launcher_robot_pcb/Dart_launcher_robot_pcb.step
55.0 x 110.0 x 15.1 mm
LED_0805_2012Metric x 3
R_0603_1608Metric x 3
Dart_launcher_robot_pcb_soldermask x 2
Dart_launcher_robot_pcb_PCB
