nusrobomaster/Dart-FYP/kicad_files/Dart_launcher_robot_pcb/Dart_launcher_robot_pcb.kicad_pcb

## KiCad design kicad_files/Dart_launcher_robot_pcb/Dart_launcher_robot_pcb.kicad_pcb (2026-04-10)

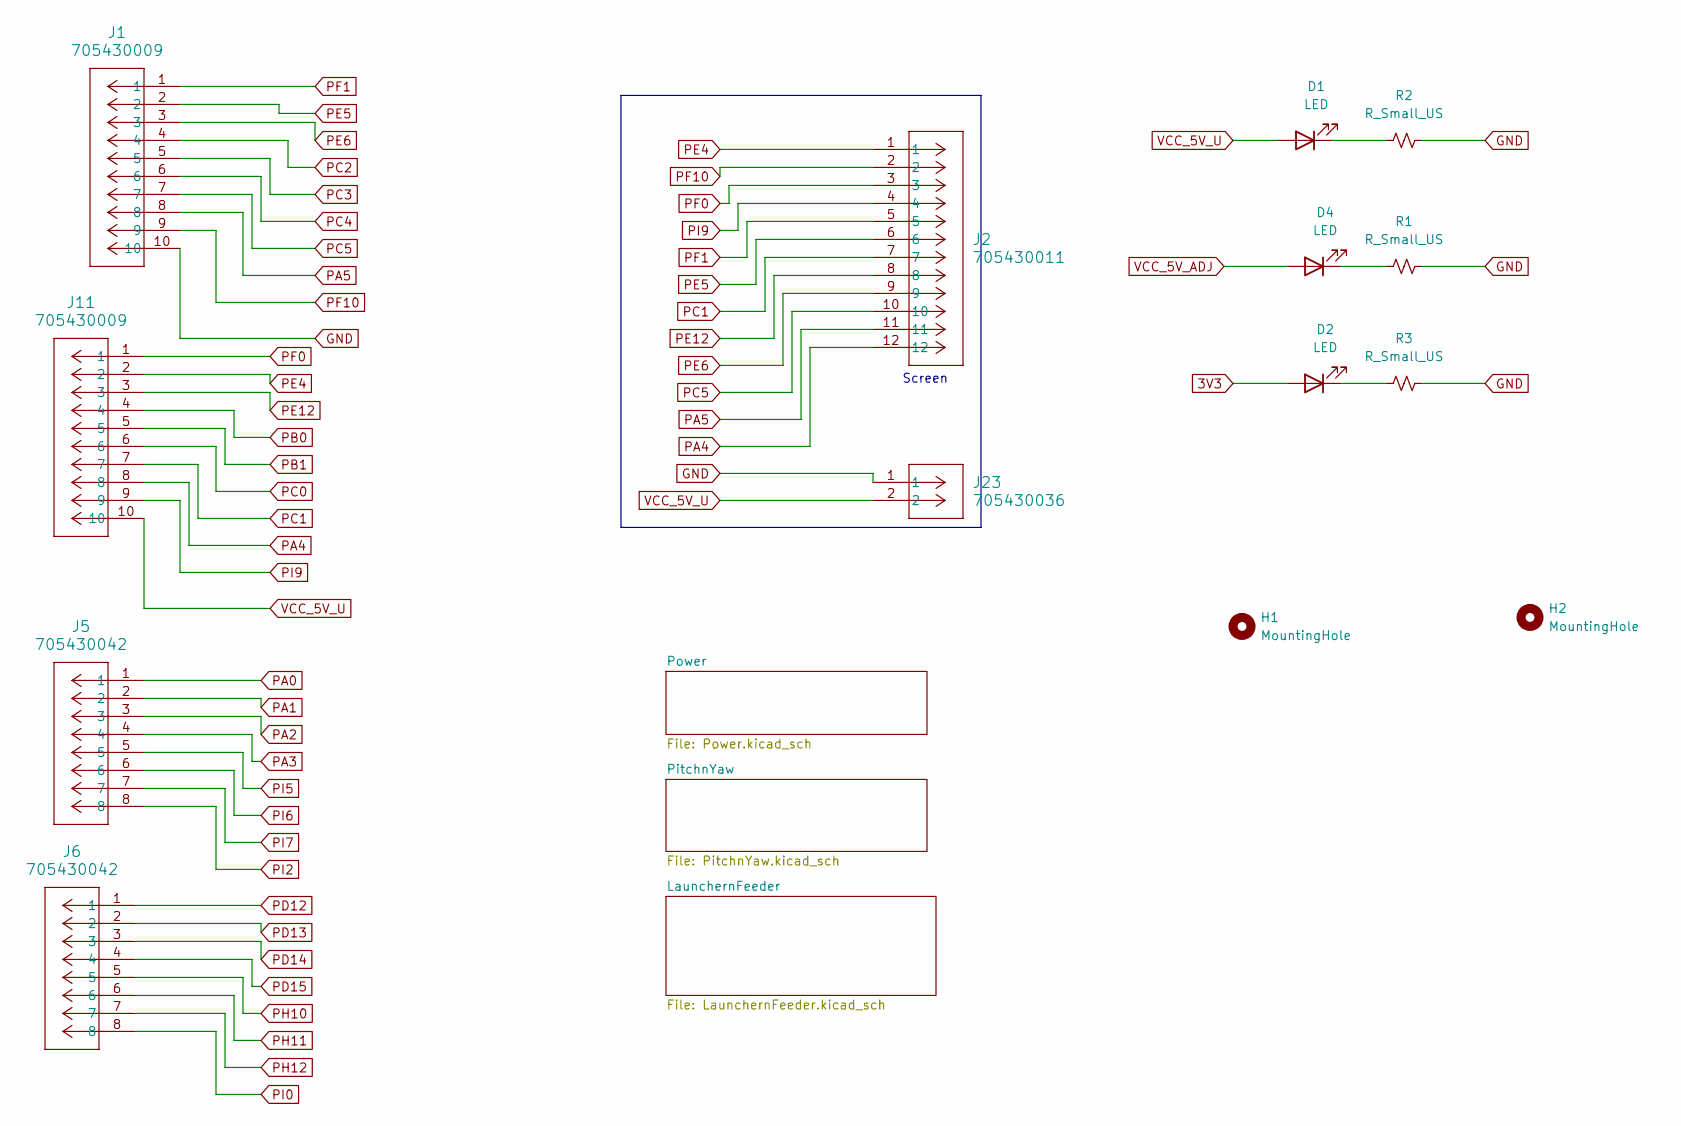
[picture p189: schematic Dart_launcher_robot_pcb.kicad_sch]

Parts:
D1, D2, D4: LED; LED_0805_2012Metric_Pad1.15x1.40mm_HandSolder
H1, H2: MountingHole; MountingHole_3.2mm_M3
J1, J11: 705430009; CONN_SDA-70543-xxxx_10_MOL
J2: 705430011; CONN_SDA-70543-xxxx_12_MOL
J5, J6: 705430042; CONN_SDA-70543-xxxx_08_MOL
J23: 705430036; CONN_SDA-70543-xxxx_02_MOL
R1, R2, R3: R_Small_US; R_0603_1608Metric_Pad0.98x0.95mm_HandSolder

Connections:
3V3: D2.2 (A); also elsewhere on the board
GND: J1.10, J23.1, R1.2, R2.2, R3.2; also elsewhere on the board
unnamed: D1.1 (K), R2.1
unnamed: D2.1 (K), R3.1
unnamed: D4.1 (K), R1.1
PA0: J5.1; also elsewhere on the board
PA1: J5.2; also elsewhere on the board
PA2: J5.3; also elsewhere on the board
PA3: J5.4; also elsewhere on the board
PA4: J2.12, J11.8
PA5: J1.8, J2.11
PB0: J11.4; also elsewhere on the board
PB1: J11.5; also elsewhere on the board
PC0: J11.6; also elsewhere on the board
PC1: J2.7, J11.7
PC2: J1.4
PC3: J1.5; also elsewhere on the board
PC4: J1.6; also elsewhere on the board
PC5: J1.7, J2.10
PD12: J6.1; also elsewhere on the board
PD13: J6.2; also elsewhere on the board
PD14: J6.3; also elsewhere on the board
PD15: J6.4; also elsewhere on the board
PE4: J2.1, J11.2
PE5: J1.2, J2.6
PE6: J1.3, J2.9
PE12: J2.8, J11.3
PF0: J2.3, J11.1
PF1: J1.1, J2.5
PF10: J1.9, J2.2
PH10: J6.5
PH11: J6.6
PH12: J6.7; also elsewhere on the board
PI0: J6.8; also elsewhere on the board
PI2: J5.8
PI5: J5.5; also elsewhere on the board
PI6: J5.6
PI7: J5.7
PI9: J2.4, J11.9
VCC_5V_ADJ: D4.2 (A); also elsewhere on the board
VCC_5V_U: D1.2 (A), J11.10, J23.2

Notes on the sheet:
Screen

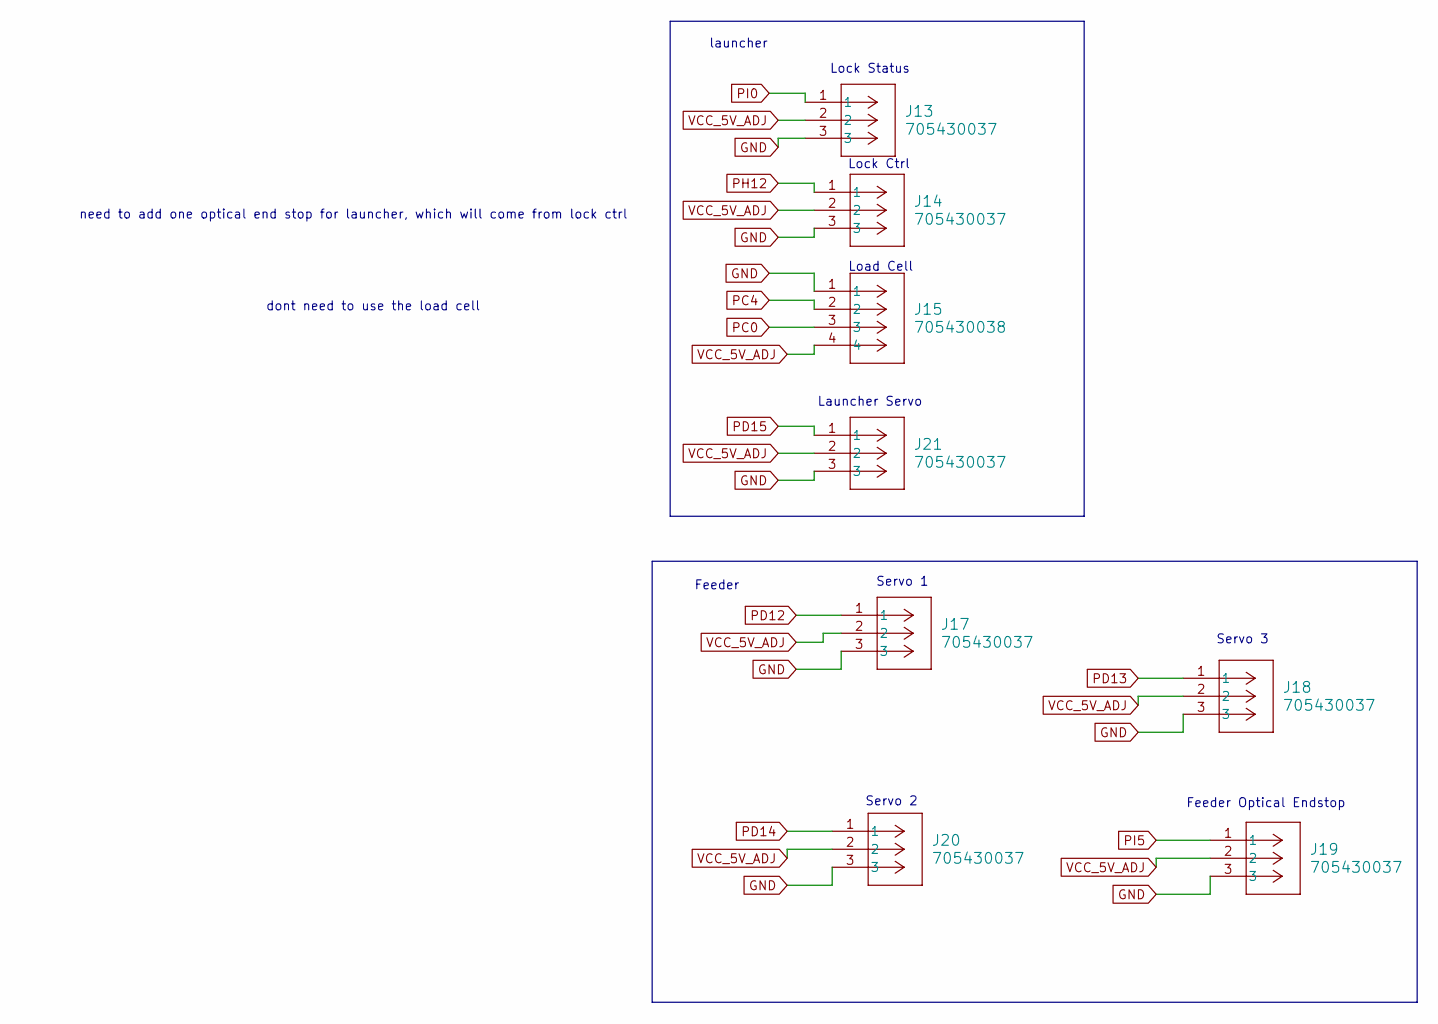
[picture p190: schematic LaunchernFeeder.kicad_sch]

Parts:
J13, J14, J17, J18, J19, J20, J21: 705430037; CONN_SDA-70543-xxxx_03_MOL
J15: 705430038; CONN_SDA-70543-xxxx_04_MOL

Connections:
GND: J13.3, J14.3, J15.1, J17.3, J18.3, J19.3, J20.3, J21.3; also elsewhere on the board
PC0: J15.3; also elsewhere on the board
PC4: J15.2; also elsewhere on the board
PD12: J17.1; also elsewhere on the board
PD13: J18.1; also elsewhere on the board
PD14: J20.1; also elsewhere on the board
PD15: J21.1; also elsewhere on the board
PH12: J14.1; also elsewhere on the board
PI0: J13.1; also elsewhere on the board
PI5: J19.1; also elsewhere on the board
VCC_5V_ADJ: J13.2, J14.2, J15.4, J17.2, J18.2, J19.2, J20.2, J21.2; also elsewhere on the board

Notes on the sheet:
Launcher Servo
Lock Ctrl
Servo 3
need to add one optical end stop for launcher, which will come from lock ctrl
launcher
Lock Status
Feeder
Servo 2
dont need to use the load cell
Load Cell
Servo 1
Feeder Optical Endstop

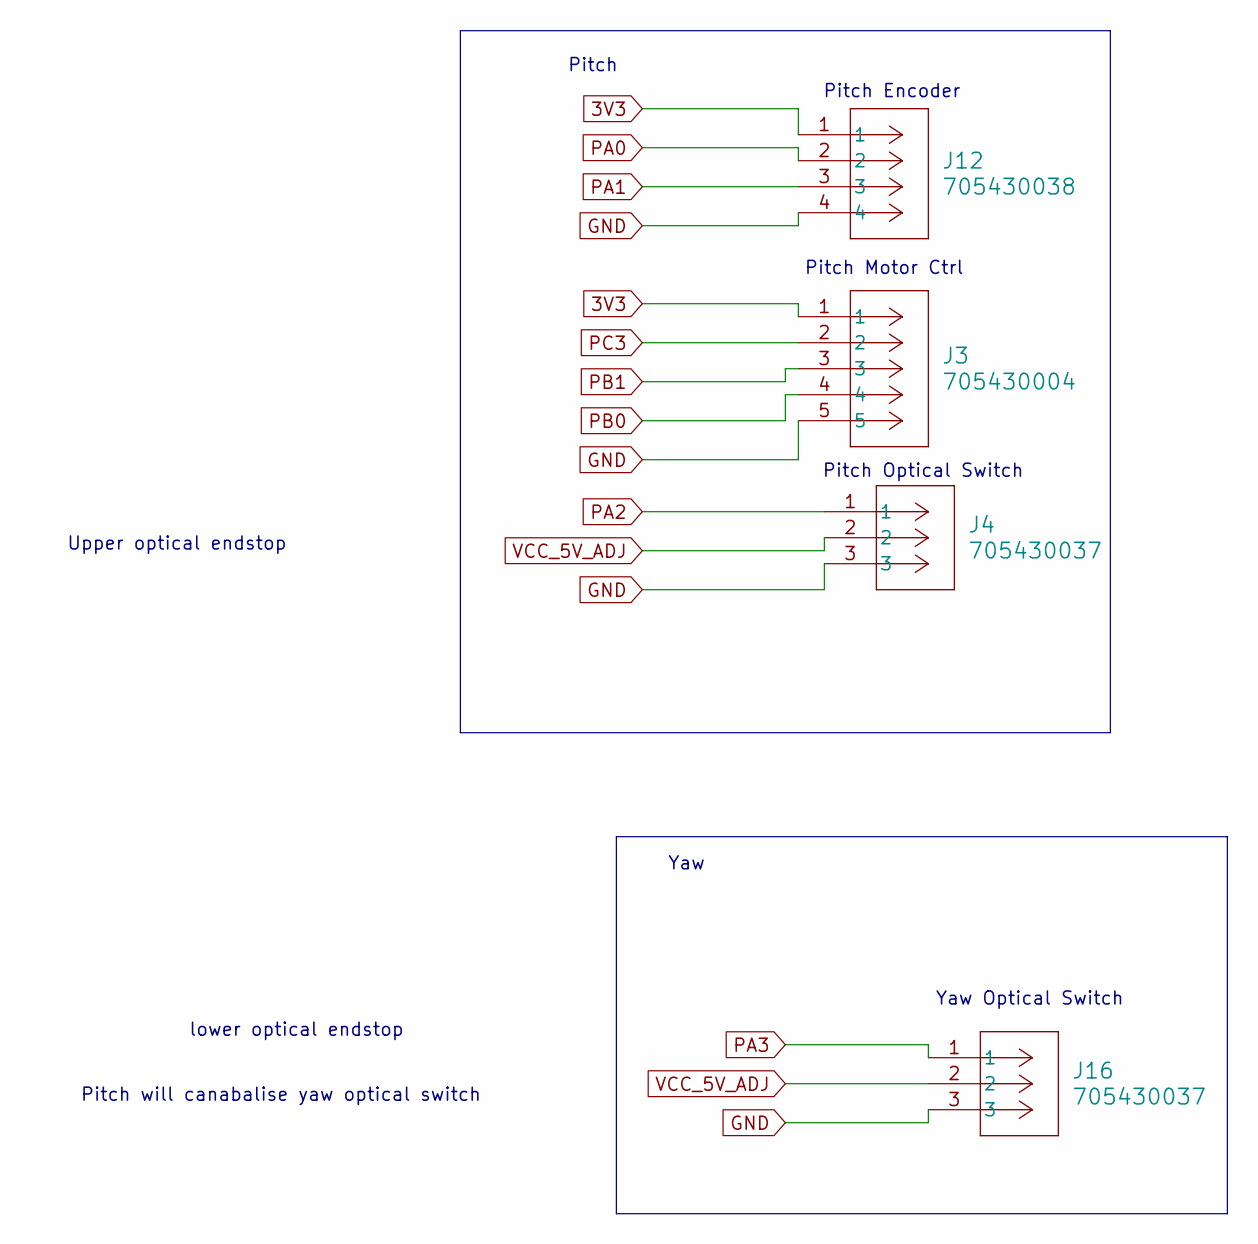
[picture p191: schematic PitchnYaw.kicad_sch]

Parts:
J3: 705430004; CONN_SDA-70543-xxxx_05_MOL
J4, J16: 705430037; CONN_SDA-70543-xxxx_03_MOL
J12: 705430038; CONN_SDA-70543-xxxx_04_MOL

Connections:
3V3: J3.1, J12.1; also elsewhere on the board
GND: J3.5, J4.3, J12.4, J16.3; also elsewhere on the board
PA0: J12.2; also elsewhere on the board
PA1: J12.3; also elsewhere on the board
PA2: J4.1; also elsewhere on the board
PA3: J16.1; also elsewhere on the board
PB0: J3.4; also elsewhere on the board
PB1: J3.3; also elsewhere on the board
PC3: J3.2; also elsewhere on the board
VCC_5V_ADJ: J4.2, J16.2; also elsewhere on the board

Notes on the sheet:
Pitch
lower optical endstop
Pitch Encoder
Pitch Motor Ctrl
Yaw
Upper optical endstop
Yaw Optical Switch
Pitch Optical Switch
Pitch will canabalise yaw optical switch

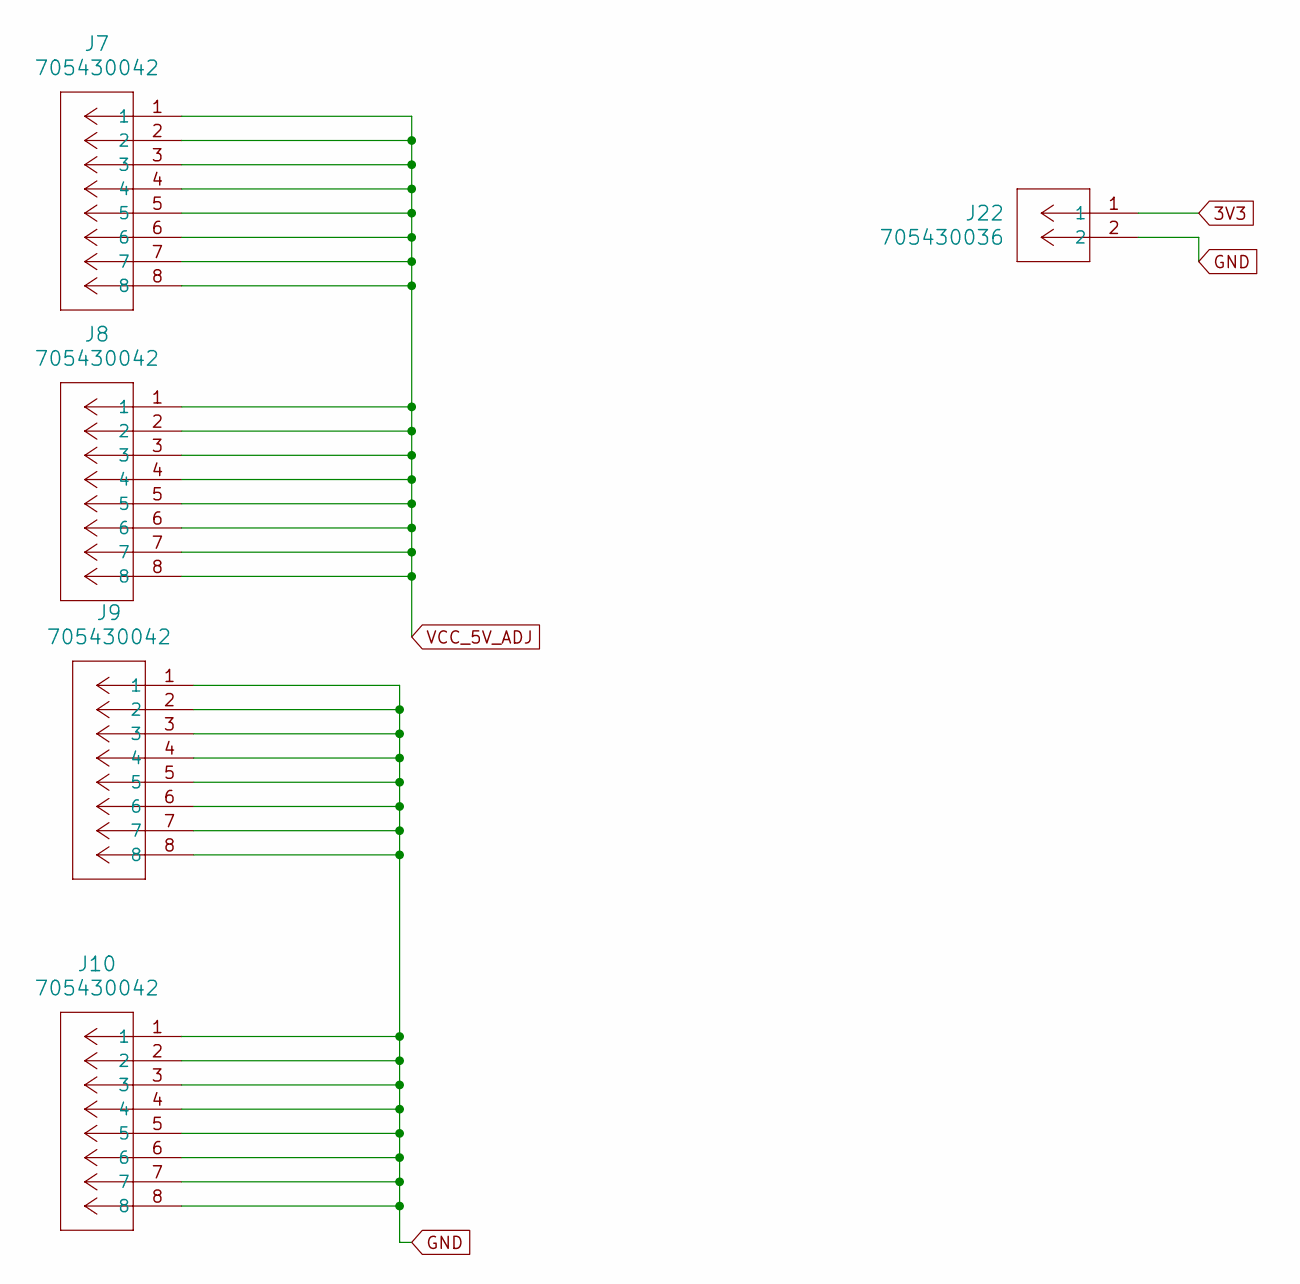
[picture p192: schematic Power.kicad_sch]

Parts:
J7, J8, J9, J10: 705430042; CONN_SDA-70543-xxxx_08_MOL
J22: 705430036; CONN_SDA-70543-xxxx_02_MOL

Connections:
3V3: J22.1; also elsewhere on the board
GND: J9.1, J9.2, J9.3, J9.4, J9.5, J9.6, J9.7, J9.8, J10.1, J10.2, J10.3, J10.4, J10.5, J10.6, J10.7, J10.8, J22.2; also elsewhere on the board
VCC_5V_ADJ: J7.1, J7.2, J7.3, J7.4, J7.5, J7.6, J7.7, J7.8, J8.1, J8.2, J8.3, J8.4, J8.5, J8.6, J8.7, J8.8; also elsewhere on the board

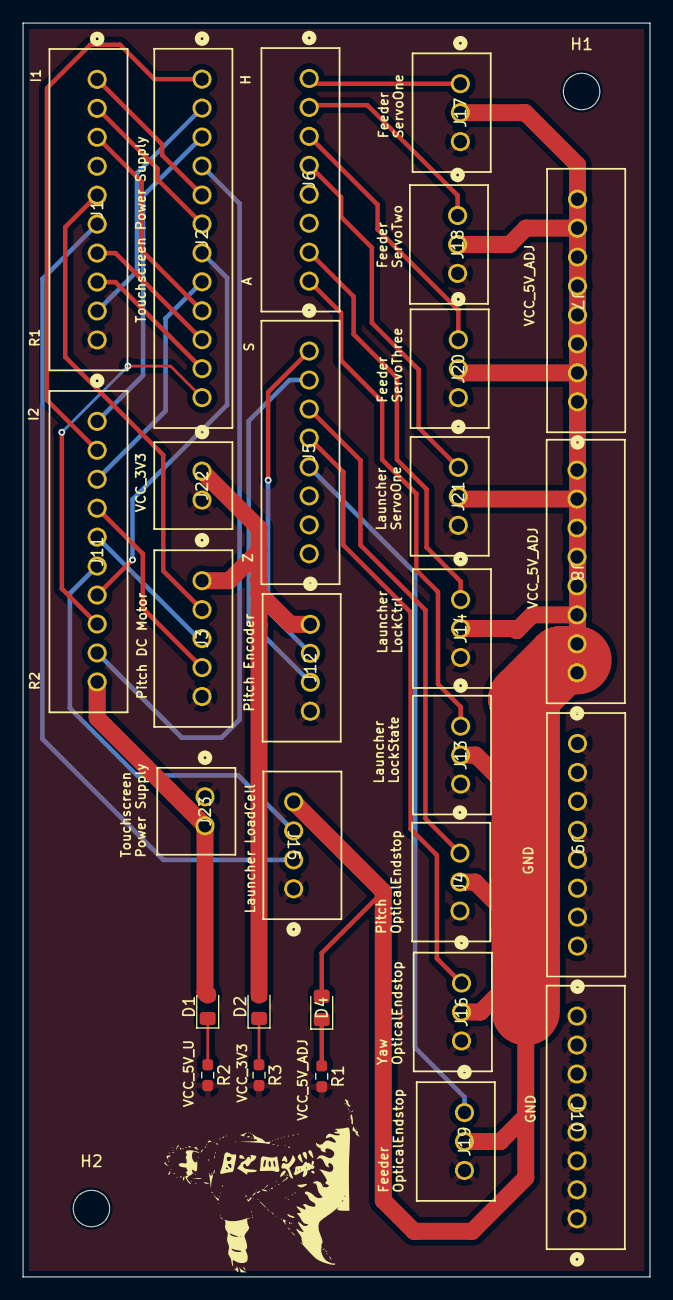
[picture p193: board Dart_launcher_robot_pcb.kicad_pcb from above]

Board: 2 copper layers, 55.0 x 110.0 mm, 31 parts (0 on the bottom side), 35 nets.
