nusrobomaster/Dart-FYP/Implement_pitch_yaw_feeder/Core/Src/main.c

/* USER CODE BEGIN Header */
/**
  ******************************************************************************
  * @file           : main.c
  * @brief          : Main program body
  ******************************************************************************
  * @attention
  *
  * Copyright (c) 2025 STMicroelectronics.
  * All rights reserved.
  *
  * This software is licensed under terms that can be found in the LICENSE file
  * in the root directory of this software component.
  * If no LICENSE file comes with this software, it is provided AS-IS.
  *
  ******************************************************************************
  */

//========================================= Power ================================================//
// LCD Module STM32 MCU
// VCC -> DC5V / 3.3V // Power
// GND -> GND // Ground
//
// Pitch encoder power note:
// - Pitch encoder needs 5V (power from a 5V rail, not GPIO)
//================================================================================================//

//======================================= LCD Interface ===========================================//
// The module defaults to SPI mode
// LCD Module STM32 MCU
// SDI (MOSI) -> PE6  // SPI data write
// SDO (MISO) -> PE5  // SPI data read (optional)
//
// LCD Module STM32 MCU
// LED       -> PC1  // Backlight control (or tie to 5V / 3.3V)
// SCK       -> PE12 // SPI clock
// LCD_RS    -> PC5  // Data / Command select
// LCD_RST   -> PA5  // LCD reset
// LCD_CS    -> PA4  // Chip select
//================================================================================================//

//===================================== Touch (Optional) ==========================================//
// If touch is not used, these pins can be left unconnected
// Touch Module STM32 MCU
// CTP_INT -> PF10 // Touch interrupt
// CTP_SDA -> PF0  // I2C data
// CTP_RST -> PI9  // Touch reset
// CTP_SCL -> PF1  // I2C clock
//================================================================================================//

//==================================== Electronic Lock ============================================//
// Lock Signal STM32 MCU
// Lock status -> PI0
//================================================================================================//

//======================================== Pitch Motor ============================================//
// Brushed DC pitch motor (H-bridge + PWM):
// 3V3 Logic Power      -> PC2           // Logic-level supply only (not for encoder)
// Forward  (Pitch up)  -> PB1 (FWD_Pin) // FWD_GPIO_Port / FWD_Pin in main.h
// Backward (Pitch down)-> PC3 (BWD_Pin) // BWD_GPIO_Port / BWD_Pin in main.h
// PWM                 -> PB0           // TIM3_CH3, mapped via PWM_TIM / PWM_CHANNEL
//
// Pitch optical endstops:
// - Upper -> PA2 (pitch upper optical endstop 45 degrees)
// - Lower -> PA3 (pitch lower optical endstop 35 degrees)
//
// Pitch Hall effect channel A and B incremental encoder:
// - A0 and A1 are the channel A and B pins of the encoder
// - A0 is the channel A pin of the encoder
// - A1 is the channel B pin of the encoder
// - The encoder requires 3.3V logic power (external 3.3V rail)
// - uses TIM2 for the encoder
//================================================================================================//

//========================================= Yaw Control ===========================================//
// Yaw control and feedback via CAN only
// No extra GPIO required
//================================================================================================//

//========================================= Launcher =============================================//
// Launcher optical endstop -> PH12 (cannot pull beyond this point)
// Launcher servo (release dart) -> PD15 (TIM4_CH4)
//================================================================================================//

//=========================================== Feeder ==============================================//
// Feeder actuation uses servos (TIM4) and a CAN motor.
//
// Feeder servo 1 -> PD12 (TIM4_CH1)
// Feeder servo 2 -> PD13 (TIM4_CH2)
// Feeder servo 3 -> PD14 (TIM4_CH3)
// Feeder optical endstop -> PI5
//
//
// Feeder CAN motor:
// - Control and feedback via CAN bus
// - No dedicated GPIO required for motor control
//================================================================================================//


/* USER CODE END Header */
/* Includes ------------------------------------------------------------------*/
#include "main.h"
#include "cmsis_os.h"
#include "usb_device.h"

/* USER CODE BEGIN Includes */
#include "remote_control.h"
#include "hx711.h"
#include "./LCD_CAP/LCD/lcd.h"
#include "./LCD_CAP/TOUCH/touch.h"
#include "./LCD_CAP/GUI/GUI.h"
#include "lvgl.h"
#include <stdio.h>
#include "ui.h"
#include "usbd_cdc_if.h"
#include <string.h>
#include "bsp_damiao.h"
#include <math.h>
#include "typedefs.h"
#include <DART_CONFIG.h>

/* USER CODE END Includes */

typedef StaticTask_t osStaticThreadDef_t;
/* USER CODE BEGIN PD */
#define MY_DISP_VER_RES LCD_H
#define MY_DISP_HOR_RES LCD_W
/* Declare buffer for 1/10 screen size; BYTES_PER_PIXEL will be 2 for RGB565. */
#define BYTES_PER_PIXEL (LV_COLOR_FORMAT_GET_SIZE(LV_COLOR_FORMAT_RGB565))
#define buffer_divide 10
static uint8_t buf1[LCD_W * LCD_H / buffer_divide * BYTES_PER_PIXEL];
//static uint8_t buf2[LCD_W * LCD_H / buffer_divide * BYTES_PER_PIXEL];
volatile lv_mutex_t lv_mutex;

#define USB_LEN 128
uint8_t usbTxtBuf[USB_LEN];
/* USER CODE END PD */

CAN_HandleTypeDef hcan1;

DMA2D_HandleTypeDef hdma2d;

I2C_HandleTypeDef hi2c2;

SPI_HandleTypeDef hspi4;
DMA_HandleTypeDef hdma_spi4_tx;

TIM_HandleTypeDef htim2;
TIM_HandleTypeDef htim3;
TIM_HandleTypeDef htim4;

UART_HandleTypeDef huart1;
DMA_HandleTypeDef hdma_usart1_rx;

/* Definitions for controlTask */
osThreadId_t controlTaskHandle;
uint32_t controlTaskBuffer[ 4096 ];
osStaticThreadDef_t controlTaskControlBlock;
const osThreadAttr_t controlTask_attributes = {
  .name = "controlTask",
  .cb_mem = &controlTaskControlBlock,
  .cb_size = sizeof(controlTaskControlBlock),
  .stack_mem = &controlTaskBuffer[0],
  .stack_size = sizeof(controlTaskBuffer),
  .priority = (osPriority_t) osPriorityNormal,
};
/* Definitions for pitchnyawTask */
osThreadId_t pitchnyawTaskHandle;
uint32_t pitchnyawTaskBuffer[ 1024 ];
osStaticThreadDef_t pitchnyawTaskControlBlock;
const osThreadAttr_t pitchnyawTask_attributes = {
  .name = "pitchnyawTask",
  .cb_mem = &pitchnyawTaskControlBlock,
  .cb_size = sizeof(pitchnyawTaskControlBlock),
  .stack_mem = &pitchnyawTaskBuffer[0],
  .stack_size = sizeof(pitchnyawTaskBuffer),
  .priority = (osPriority_t) osPriorityNormal,
};
/* Definitions for launcherTask */
osThreadId_t launcherTaskHandle;
uint32_t launcherTaskBuffer[ 1024 ];
osStaticThreadDef_t launcherTaskControlBlock;
const osThreadAttr_t launcherTask_attributes = {
  .name = "launcherTask",
  .cb_mem = &launcherTaskControlBlock,
  .cb_size = sizeof(launcherTaskControlBlock),
  .stack_mem = &launcherTaskBuffer[0],
  .stack_size = sizeof(launcherTaskBuffer),
  .priority = (osPriority_t) osPriorityNormal,
};
/* USER CODE BEGIN PV */
extern RC_ctrl_t rc_ctrl;  /* defined in remote_control.c with guard to avoid affecting adjacent variables */
HX711 hx;
int32_t weight;
int32_t value;
extern int16_t _width;       								///< (oriented) display width
extern int16_t _height;
int32_t count = 450;
char buf_txt[32];
volatile lv_display_t * display1;
volatile uint8_t touch_flag;
static lv_indev_t * touch_indev;
static lv_obj_t * keypad_ta;


extern volatile dm_motor_t dm_pitch_motor;
extern volatile dm_motor_t dm_yaw_motor;
extern volatile dm_motor_t dm_feeder_motor;
extern volatile dm_motor_t dm_launching_motor;

 bool op_sen_yaw_45deg;
 bool op_sen_yaw_35deg;
extern bool op_sen_launcher_limits;
extern bool op_sen_feeder;
//extern bool lock;
/* USER CODE END PV */

void SystemClock_Config(void);
static void MX_GPIO_Init(void);
static void MX_DMA_Init(void);
static void MX_CAN1_Init(void);
static void MX_USART1_UART_Init(void);
static void MX_SPI4_Init(void);
static void MX_DMA2D_Init(void);
static void MX_I2C2_Init(void);
static void MX_TIM3_Init(void);
static void MX_TIM2_Init(void);
static void MX_TIM4_Init(void);
void ControlTask(void *argument);
void PitchnYawTask(void *argument);
void LauncherTask(void *argument);

/* USER CODE BEGIN PFP */
static void lvgl_port_init(void);
static void touch_read_cb(lv_indev_t * indev, lv_indev_data_t * data);

/* USER CODE END PFP */

/* USER CODE BEGIN 0 */
void setup_can(){
 CAN_FilterTypeDef can_filter_st = {0};
 can_filter_st.FilterActivation = ENABLE;
 can_filter_st.FilterMode = CAN_FILTERMODE_IDMASK;
 can_filter_st.FilterScale = CAN_FILTERSCALE_32BIT;
 can_filter_st.FilterIdHigh = 0;
 can_filter_st.FilterIdLow = 0;
 can_filter_st.FilterMaskIdHigh = 0;
 can_filter_st.FilterMaskIdLow = 0;
 can_filter_st.FilterBank=0;
 can_filter_st.FilterFIFOAssignment = CAN_RX_FIFO0;
 HAL_CAN_ConfigFilter(&hcan1, &can_filter_st);
 HAL_CAN_Start(&hcan1);
 HAL_CAN_ActivateNotification(&hcan1,CAN_IT_RX_FIFO0_MSG_PENDING | CAN_IT_RX_FIFO0_FULL| CAN_IT_RX_FIFO0_OVERRUN);
}


/* Launcher absolute position handling is implemented in launcherTask.c.
 * main.c only initializes and uses the interface (e.g. launcher_turns_reset). */

void HAL_CAN_RxFifo0MsgPendingCallback(CAN_HandleTypeDef *hcan){
	CAN_RxHeaderTypeDef rx_header;
	uint8_t rx_buffer[8];
	HAL_CAN_DeactivateNotification(hcan,
	  CAN_IT_RX_FIFO0_MSG_PENDING | CAN_IT_RX_FIFO0_FULL| CAN_IT_RX_FIFO0_OVERRUN);
	HAL_CAN_GetRxMessage(hcan, CAN_RX_FIFO0, &rx_header, rx_buffer);

	if (rx_header.StdId == 0x00) {
		/* D[0] lower 4 bits = motor ID, upper 4 = ERR (per DM-J8009 manual). Motor IDs must have unique lower 4 bits. */
		uint8_t motor_id = rx_buffer[0] & 0x0F;
		if (motor_id == (dm_pitch_motor.id & 0x0F)) {
			dm_fbdata(&dm_pitch_motor, rx_buffer);
		} else if (motor_id == (dm_yaw_motor.id & 0x0F)) {
			dm_fbdata(&dm_yaw_motor, rx_buffer);
		} else if (motor_id == (dm_feeder_motor.id & 0x0F)) {
			dm_fbdata(&dm_feeder_motor, rx_buffer);
		} else if (motor_id == (dm_launching_motor.id & 0x0F)) {
			dm_fbdata(&dm_launching_motor, rx_buffer);
		}
	}
	HAL_CAN_ActivateNotification(hcan, CAN_IT_RX_FIFO0_MSG_PENDING | CAN_IT_RX_FIFO0_FULL| CAN_IT_RX_FIFO0_OVERRUN);
}

#define SPEED rc_ctrl.rc.ch[0]

void HAL_GPIO_EXTI_Callback(uint16_t GPIO_Pin) {
//   if (GPIO_Pin == GPIO_PIN_0){
//		lock = true;
//   }
   if (GPIO_Pin == GPIO_PIN_10) {
        touch_flag = 1;
    }
   if (GPIO_Pin == GPIO_PIN_2){
    op_sen_yaw_45deg = true;
   }
   if (GPIO_Pin == GPIO_PIN_3){
    op_sen_yaw_35deg = true;
   }
   if (GPIO_Pin == GPIO_PIN_12){
    op_sen_launcher_limits = true;
   }
   if (GPIO_Pin == GPIO_PIN_5){
    op_sen_feeder = true;
   }
}

void tft_set_addr_window(uint16_t x0,uint16_t y0,uint16_t x1,uint16_t y1)
{
    uint8_t caset[4] = { x0>>8, x0&0xFF, x1>>8, x1&0xFF };
    uint8_t raset[4] = { y0>>8, y0&0xFF, y1>>8, y1&0xFF };

    LCD_WR_REG(0x2A);
    LCD_WR_DATA(caset[0]);
    LCD_WR_DATA(caset[1]);
    LCD_WR_DATA(caset[2]);
    LCD_WR_DATA(caset[3]);

    LCD_WR_REG(0x2B);
    LCD_WR_DATA(raset[0]);
    LCD_WR_DATA(raset[1]);
    LCD_WR_DATA(raset[2]);
    LCD_WR_DATA(raset[3]);

    LCD_WR_REG(0x2C); // RAMWR
}

void tft_put_pixel(uint16_t x,uint16_t y,uint16_t color)
{
    tft_set_addr_window(x,y,x,y);
    Lcd_WriteData_16Bit(color);
}


void my_flush_cb(lv_display_t * display, const lv_area_t * area, uint8_t * px_map)
{
    uint32_t w = (uint32_t)(area->x2 - area->x1 + 1);
    uint32_t h = (uint32_t)(area->y2 - area->y1 + 1);
    uint32_t size = w * h * BYTES_PER_PIXEL;

    LCD_SetWindows(area->x1, area->y1, area->x2, area->y2);
    LCD_CS_CLR;
    LCD_RS_SET;
    while (size > 0U) {
      uint16_t chunk = (size > 0xFFFFU) ? 0xFFFFU : (uint16_t)size;
      HAL_SPI_Transmit(&hspi4, px_map, chunk, HAL_MAX_DELAY);
      px_map += chunk;
      size -= chunk;
    }
    LCD_CS_SET;
    lv_display_flush_ready(display);
}

static void lvgl_port_init(void)
{
  lv_init();
  lv_tick_set_cb(HAL_GetTick);

  display1 = lv_display_create(MY_DISP_VER_RES, MY_DISP_HOR_RES);
  lv_display_set_color_format((lv_display_t *)display1, LV_COLOR_FORMAT_RGB565_SWAPPED);
  lv_display_set_buffers(display1, buf1, NULL, sizeof(buf1), LV_DISPLAY_RENDER_MODE_PARTIAL);
  lv_display_set_flush_cb(display1, my_flush_cb);

  touch_indev = lv_indev_create();
  lv_indev_set_type(touch_indev, LV_INDEV_TYPE_POINTER);
  lv_indev_set_read_cb(touch_indev, touch_read_cb);
  lv_indev_set_display(touch_indev, (lv_display_t *)display1);
}

static void touch_read_cb(lv_indev_t * indev, lv_indev_data_t * data)
{
  (void)indev;
  if (tp_dev.scan) {
    tp_dev.scan();
  }

  if (tp_dev.sta & TP_PRES_DOWN) {
    data->state = LV_INDEV_STATE_PRESSED;
    data->point.x = tp_dev.x[0];
    data->point.y = tp_dev.y[0];
  } else {
    data->state = LV_INDEV_STATE_RELEASED;
  }
}


/* USER CODE END 0 */

/**
  * @brief  The application entry point.
  * @retval int
  */
int main(void)
{
  /* MCU Configuration--------------------------------------------------------*/

  /* Reset of all peripherals, Initializes the Flash interface and the Systick. */
  HAL_Init();

  /* Configure the system clock */
  SystemClock_Config();

  /* Initialize all configured peripherals */
  MX_GPIO_Init();
  MX_DMA_Init();
  MX_CAN1_Init();
  MX_USART1_UART_Init();
  MX_SPI4_Init();
  MX_DMA2D_Init();
  MX_I2C2_Init();
  MX_TIM3_Init();
  MX_TIM2_Init();
  MX_TIM4_Init();
  /* USER CODE BEGIN 2 */
  MX_USB_DEVICE_Init();

//  HAL_GPIO_WritePin(GPIOE, GPIO_PIN_4, GPIO_PIN_SET);
//  HAL_GPIO_WritePin(GPIOB, GPIO_PIN_1, GPIO_PIN_SET);
  setup_can();
  remote_control_init();
//  hx711_init(&hx, GPIOF, GPIO_PIN_0, GPIOF, GPIO_PIN_1,HX711_GAIN_128);
  LCD_Init();
  LCD_direction(1);
  TP_Init();

  lvgl_port_init();
  HAL_Delay(3000);
  dm_motor_init();

//  uint32_t counting = 0;
//  uint32_t counter = 0;
  /* USER CODE END 2 */

  /* Init scheduler */
  osKernelInitialize();

  /* USER CODE BEGIN RTOS_MUTEX */
  /* add mutexes, ... */
//  lv_mutex_init(&lv_mutex);
  /* USER CODE END RTOS_MUTEX */

  /* USER CODE BEGIN RTOS_SEMAPHORES */
  /* add semaphores, ... */
  /* USER CODE END RTOS_SEMAPHORES */

  /* USER CODE BEGIN RTOS_TIMERS */
  /* start timers, add new ones, ... */
  /* USER CODE END RTOS_TIMERS */

  /* USER CODE BEGIN RTOS_QUEUES */
  /* add queues, ... */
  /* USER CODE END RTOS_QUEUES */

  /* Create the thread(s) */
  /* creation of controlTask */
  controlTaskHandle = osThreadNew(ControlTask, NULL, &controlTask_attributes);

  /* creation of pitchnyawTask */
  pitchnyawTaskHandle = osThreadNew(PitchnYawTask, NULL, &pitchnyawTask_attributes);

  /* creation of launcherTask */
  launcherTaskHandle = osThreadNew(LauncherTask, NULL, &launcherTask_attributes);

  /* USER CODE BEGIN RTOS_THREADS */
  /* add threads, ... */
  /* USER CODE END RTOS_THREADS */

  /* USER CODE BEGIN RTOS_EVENTS */
  /* add events, ... */
  ui_init();
  /* USER CODE END RTOS_EVENTS */

  /* Start scheduler */
  osKernelStart();

  /* We should never get here as control is now taken by the scheduler */
  /* Infinite loop */
  /* USER CODE BEGIN WHILE */
  while (1)
  {
    /* USER CODE END WHILE */

    /* USER CODE BEGIN 3 */
  }
  /* USER CODE END 3 */
}

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
/* USER CODE BEGIN Header_ControlTask */
/**
  * @brief  Function implementing the controlTask thread.
  * @param  argument: Not used
  * @retval None
  */
/* USER CODE END Header_ControlTask */
__weak void ControlTask(void *argument)
{
  /* init code for USB_DEVICE */
  MX_USB_DEVICE_Init();
  /* USER CODE BEGIN 5 */

//  uint32_t counting = 0;
//
//  int counter = 42;
  /* Infinite loop */
  for(;;)
  {
	  osDelay(1000);
//    uint32_t delay = lv_timer_handler();
//    if (delay < 5U) {
//      delay = 5U;
//    }
//    osDelay(delay);

  }
  /* USER CODE END 5 */
}

/* USER CODE BEGIN Header_PitchnYawTask */
/**
* @brief Function implementing the pitchnyawTask thread.
* @param argument: Not used
* @retval None
*/
/* USER CODE END Header_PitchnYawTask */
__weak void PitchnYawTask(void *argument)
{
  /* USER CODE BEGIN PitchnYawTask */
  /* Infinite loop */
  for(;;)
  {
    osDelay(1);
  }
  /* USER CODE END PitchnYawTask */
}

/* USER CODE BEGIN Header_LauncherTask */
/**
* @brief Function implementing the launcherTask thread.
* @param argument: Not used
* @retval None
*/
/* USER CODE END Header_LauncherTask */
__weak void LauncherTask(void *argument)
{
  /* USER CODE BEGIN LauncherTask */
  /* Infinite loop */
  for(;;)
  {
    osDelay(1);
  }
  /* USER CODE END LauncherTask */
}

/**
  * @brief  Period elapsed callback in non blocking mode
  * @note   This function is called  when TIM6 interrupt took place, inside
  * HAL_TIM_IRQHandler(). It makes a direct call to HAL_IncTick() to increment
  * a global variable "uwTick" used as application time base.
  * @param  htim : TIM handle
  * @retval None
  */
void HAL_TIM_PeriodElapsedCallback(TIM_HandleTypeDef *htim)
{
  if (htim->Instance == TIM6) {
    HAL_IncTick();
  }
}

/**
  * @brief  This function is executed in case of error occurrence.
  * @retval None
  */
void Error_Handler(void)
{
  /* USER CODE BEGIN Error_Handler_Debug */
  /* User can add his own implementation to report the HAL error return state */
  __disable_irq();
  while (1)
  {

  }
  /* USER CODE END Error_Handler_Debug */
}

#ifdef  USE_FULL_ASSERT
/**
  * @brief  Reports the name of the source file and the source line number
  *         where the assert_param error has occurred.
  * @param  file: pointer to the source file name
  * @param  line: assert_param error line source number
  * @retval None
  */
void assert_failed(uint8_t *file, uint32_t line)
{
  /* USER CODE BEGIN 6 */
  /* User can add his own implementation to report the file name and line number,
     ex: printf("Wrong parameters value: file %s on line %d\r\n", file, line) */
  /* USER CODE END 6 */
}
#endif /* USE_FULL_ASSERT */
