nusrobomaster/Dart-FYP/Implement_pitch_yaw_feeder/Core/Inc/main.h

#define LCD_LED_GPIO_Port    GPIOC
#define LCD_LED_Pin          GPIO_PIN_1
#define LCD_RS_GPIO_Port     GPIOC
#define LCD_RS_Pin           GPIO_PIN_5
#define LCD_RST_GPIO_Port    GPIOA
#define LCD_RST_Pin          GPIO_PIN_5
#define LCD_CS_GPIO_Port     GPIOA
#define LCD_CS_Pin           GPIO_PIN_4
#define LCD_MOSI_GPIO_Port   GPIOE
#define LCD_MOSI_Pin         GPIO_PIN_6
#define LCD_MISO_GPIO_Port   GPIOE
#define LCD_MISO_Pin         GPIO_PIN_5
#define LCD_SCK_GPIO_Port    GPIOE
#define LCD_SCK_Pin          GPIO_PIN_12
#define CTP_INT_GPIO_Port    GPIOF
#define CTP_INT_Pin          GPIO_PIN_10
#define CTP_SDA_GPIO_Port    GPIOF
#define CTP_SDA_Pin          GPIO_PIN_0
#define CTP_SCL_GPIO_Port    GPIOF
#define CTP_SCL_Pin          GPIO_PIN_1
#define CTP_RST_GPIO_Port    GPIOI
#define CTP_RST_Pin          GPIO_PIN_9
#define LOCK_GPIO_Port       GPIOI
#define LOCK_Pin             GPIO_PIN_0
#define FWD_GPIO_Port        GPIOB
#define FWD_Pin              GPIO_PIN_1
#define BWD_GPIO_Port        GPIOC
#define BWD_Pin              GPIO_PIN_3
#define PITCH_PWM_GPIO_Port  GPIOB
#define PITCH_PWM_Pin        GPIO_PIN_0
#define PITCH_PWM_TIM        htim3
#define PITCH_PWM_CHANNEL    TIM_CHANNEL_3
#define PWM_TIM              htim3
#define PWM_CHANNEL          TIM_CHANNEL_3
#define PITCH_ENDSTOP_UPPER_GPIO_Port  GPIOA
#define PITCH_ENDSTOP_UPPER_Pin        GPIO_PIN_2
#define PITCH_ENDSTOP_LOWER_GPIO_Port  GPIOA
#define PITCH_ENDSTOP_LOWER_Pin        GPIO_PIN_3
#define PITCH_ENC_CHA_GPIO_Port  GPIOA
#define PITCH_ENC_CHA_Pin        GPIO_PIN_0
#define PITCH_ENC_CHB_GPIO_Port  GPIOA
#define PITCH_ENC_CHB_Pin        GPIO_PIN_1
#define PITCH_ENC_TIM        htim2
#define LAUNCHER_ENDSTOP_GPIO_Port  GPIOH
#define LAUNCHER_ENDSTOP_Pin        GPIO_PIN_12
#define LAUNCHER_SERVO_GPIO_Port   GPIOD
#define LAUNCHER_SERVO_Pin         GPIO_PIN_15
#define LAUNCHER_SERVO_TIM         htim4
#define LAUNCHER_SERVO_CHANNEL     TIM_CHANNEL_4
#define FEEDER_SERVO1_GPIO_Port    GPIOD
#define FEEDER_SERVO1_Pin         GPIO_PIN_12
#define FEEDER_SERVO2_GPIO_Port   GPIOD
#define FEEDER_SERVO2_Pin         GPIO_PIN_13
#define FEEDER_SERVO3_GPIO_Port   GPIOD
#define FEEDER_SERVO3_Pin         GPIO_PIN_14
#define FEEDER_ENDSTOP_GPIO_Port  GPIOI
#define FEEDER_ENDSTOP_Pin        GPIO_PIN_5
#define FEEDER_SERVO_TIM          htim4
#define FEEDER_SERVO1_CHANNEL      TIM_CHANNEL_1
#define FEEDER_SERVO2_CHANNEL      TIM_CHANNEL_2
#define FEEDER_SERVO3_CHANNEL      TIM_CHANNEL_3
