nusrobomaster/Dart-FYP/Implement_pitch_yaw_feeder/Core/Src/PID.c

/*
 * PID.c
 *
 *  Created on: Jul 14, 2024
 *      Author: YI MING
 */
#include "PID.h"




void PID_Init(PID *pid, float kp, float ki, float kd, float min_output, float max_output) {
    pid->kp = kp;
    pid->ki = ki;
    pid->kd = kd;
    pid->prev_error = 0;
    pid->integral = 0;
    pid->max_output = max_output;
    pid->min_output = min_output;
}

void PID_Compute(PID *pid, float setpoint, float measured_value, float dt, float deadzone) {
    float error = setpoint - measured_value;
    if (error < deadzone && error > -deadzone ){
    	error = 0.0;
    }
    pid->integral += error * dt;
    float derivative = (error - pid->prev_error) / dt;
    float output = pid->kp * error + pid->ki * pid->integral + pid->kd * derivative;

    // Clamp the output to the specified max and min limits
    if (output > pid->max_output) {
        output = pid->max_output;
    } else if (output < pid->min_output) {
        output = pid->min_output;
    }

    pid->prev_error = error;
    pid->output =  output;
}

void PID_CascadeCalc(CascadePID *pid,float angleRef,float angleFdb,float speedFdb, float dt)
{
	PID_Compute(&pid->outer,angleRef,angleFdb,dt,0);
	PID_Compute(&pid->inner,pid->outer.output,speedFdb,dt,0);
	pid->output=pid->inner.output;
}
