nusrobomaster/Dart-FYP/Implement_pitch_yaw_feeder/Core/Src/Tasks/ptichnyawTask.c

/*
 * ptichnyawtTask.c
 *
 *  Created on: Jan 18, 2026
 *      Author: Barry Ang
 */

#include <DART_CONFIG.h>
#include "main.h"
#include "bsp_damiao.h"
#include "pitchnyawTask.h"
#include <math.h>
#include <stdbool.h>
#include "../ui_interface.h"
#include "remote_control.h"
#include <stdint.h>
#include "PID.h"

typedef enum {
    MODE_BREAKING = 0,
    MODE_FORWARD = 1,
    MODE_BACKWARD = 2,
	MODE_COASTING = 3
} Mode_t;

Mode_t mode = MODE_BREAKING;

extern volatile dm_motor_t dm_yaw_motor;
extern CAN_HandleTypeDef hcan1;


float yaw_angle = ZERO / DEG2RAD;
float pitch_angle = 30.0f; // example command in-range

PID Pitch_PID;

float yaw_threshold_velocity = 4.0f;

extern bool op_sen_yaw_45deg;
extern bool op_sen_yaw_35deg;

extern TIM_HandleTypeDef htim2;

float cur_pitch_deg_angle;
float yaw_velocity;


static inline void Motor_Stop(void)
{
    // PWM to 0
    __HAL_TIM_SET_COMPARE(&PWM_TIM, PWM_CHANNEL, 0);

    // both direction pins low
    HAL_GPIO_WritePin(FWD_GPIO_Port, FWD_Pin, GPIO_PIN_RESET);
    HAL_GPIO_WritePin(BWD_GPIO_Port, BWD_Pin, GPIO_PIN_RESET);
}

/* Set direction safely (never both high) */
static inline void Motor_SetDirection(Mode_t direction)
{
  switch (direction) {
	  case MODE_COASTING:
		  HAL_GPIO_WritePin(FWD_GPIO_Port, FWD_Pin, GPIO_PIN_RESET);
		  HAL_GPIO_WritePin(BWD_GPIO_Port, BWD_Pin, GPIO_PIN_RESET);
		  break;
	  case MODE_FORWARD:
		HAL_GPIO_WritePin(FWD_GPIO_Port, FWD_Pin, GPIO_PIN_SET);
		HAL_GPIO_WritePin(BWD_GPIO_Port, BWD_Pin, GPIO_PIN_RESET);
		break;
	  case MODE_BACKWARD:
		HAL_GPIO_WritePin(FWD_GPIO_Port, FWD_Pin, GPIO_PIN_RESET);
		HAL_GPIO_WritePin(BWD_GPIO_Port, BWD_Pin, GPIO_PIN_SET);
		break;
	  case MODE_BREAKING:
		HAL_GPIO_WritePin(FWD_GPIO_Port, FWD_Pin, GPIO_PIN_SET);
		HAL_GPIO_WritePin(BWD_GPIO_Port, BWD_Pin, GPIO_PIN_SET);
		break;
	  default:
		HAL_GPIO_WritePin(FWD_GPIO_Port, FWD_Pin, GPIO_PIN_RESET);
		HAL_GPIO_WritePin(BWD_GPIO_Port, BWD_Pin, GPIO_PIN_RESET);
		break;
  }
}

static inline void Motor_SetPwmCounts(uint16_t duty)
{
    if (duty > PWM_MAX_COUNTS) duty = PWM_MAX_COUNTS;
    __HAL_TIM_SET_COMPARE(&PWM_TIM, PWM_CHANNEL, duty);
}

#include <stdint.h>

static inline void Motor_SetTorque(float torque_cmd)
{
    float abs_torque;
    uint16_t duty;

    if (torque_cmd > 0.0f) {
        Motor_SetDirection(MODE_FORWARD);
        abs_torque = torque_cmd;
    }
    else if (torque_cmd < 0.0f) {
        Motor_SetDirection(MODE_BACKWARD);
        abs_torque = -torque_cmd;
    }
    else {
        Motor_SetDirection(MODE_COASTING);
        Motor_SetPwmCounts(0);
        return;
    }

    /* Clamp torque magnitude to max allowed */
    if (abs_torque > TORQUE_MAX) {
        abs_torque = TORQUE_MAX;
    }

    /* Map torque to PWM counts */
    duty = (uint16_t)((abs_torque / TORQUE_MAX) * PWM_MAX_COUNTS);

    Motor_SetPwmCounts(duty);
}

static float clamp_yaw_angle_deg(float yaw_deg)
{
	if (yaw_deg > RIGHT_YAW_LIMIT_DEG) {
		return RIGHT_YAW_LIMIT_DEG;
	}
	if (yaw_deg < LEFT_YAW_LIMIT_DEG) {
		return LEFT_YAW_LIMIT_DEG;
	}
	return yaw_deg;
}

/* Clamp yaw setpoint to [LEFT_YAW_LIMIT_DEG, RIGHT_YAW_LIMIT_DEG]; sync UI if value changed. */
static void clamp_yaw_sync_ui(void)
{
	float y_prev = yaw_angle;
	yaw_angle = clamp_yaw_angle_deg(yaw_angle);
	if (fabsf(yaw_angle - y_prev) > 1e-3f) {
		ui_interface_apply_value_direct(SELECT_YAW_ANGLE, yaw_angle);
	}
}

static void testing_pitch_n_yaw(void);
static void testing_yaw_screen(void);
static void testing_pitch_screen(void);

void PitchnYawTask(void *argument)
{
    /* USER CODE BEGIN YawTask */

	// Initialize the encoder TIM2 for the pitch motor
	HAL_TIM_Encoder_Start(&htim2,  TIM_CHANNEL_ALL);
	taskENTER_CRITICAL();
#if TESTING || TESTING_WOUT_YAW
	dm_yaw_motor.ctrl.pos_set = 0.0f;
	dm_yaw_motor.ctrl.vel_set = 0.0f;
	dm_yaw_motor.ctrl.kp_set  = 0.0f;
	dm_yaw_motor.ctrl.kd_set  = YAW_KD_SET;
	dm_yaw_motor.ctrl.tor_set = 0.0f;
#else
    dm_yaw_motor.ctrl.pos_set = 0.0f;
    dm_yaw_motor.ctrl.vel_set = 0.0f;
    dm_yaw_motor.ctrl.kp_set  = YAW_KP_SET;
    dm_yaw_motor.ctrl.kd_set  = YAW_KD_SET;
	dm_yaw_motor.ctrl.tor_set = 0.0f;
#endif
    taskEXIT_CRITICAL();


    /* Pitch single-loop PID: angle -> torque */
    PID_Init(&Pitch_PID, 200.0f, 0.0f, 10.0f, -TORQUE_MAX, TORQUE_MAX);

	HAL_GPIO_WritePin(GPIOC, GPIO_PIN_2, GPIO_PIN_SET);

	HAL_TIM_PWM_Start(&PWM_TIM, PWM_CHANNEL);
	Motor_Stop();

	static TickType_t last = 0;

	#if !(TESTING | TESTING_WOUT_YAW)
		yaw_angle = ZERO / DEG2RAD;
		dm_yaw_motor.ctrl.pos_set = ZERO;
		dm_ctrl_send(&hcan1, &dm_yaw_motor);
		while (!op_sen_yaw_35deg || !op_sen_yaw_45deg){
			//need check direction
			Motor_SetTorque(125);
		}
		if (op_sen_yaw_35deg){
			__HAL_TIM_SET_COUNTER(&htim2, 0);
		}

	#endif

	/* Infinite loop */
    for (;;)
    {
		#if TESTING || TESTING_WOUT_YAW
			#if TESTING_PITCH_YAW_INPUT == 0
				testing_pitch_n_yaw();
			#elif TESTING_PITCH_YAW_INPUT == 1
				testing_yaw_screen();
			#elif TESTING_PITCH_YAW_INPUT == 2
				testing_pitch_screen();
			#else
				#error "TESTING_PITCH_YAW_INPUT must be 0, 1, or 2"
			#endif
    	#else

		/* Get set values from UI interface */

    	if (ui_interface_get_selection() == SELECT_RC){
    		RC_ctrl_t rc;
    		get_remote_control_snapshot(&rc);
    		if (rc.rc.s[0] != 0){
				yaw_angle -= (float)rc.rc.ch[2] / 100.0f;
				//NEED TO CHECK FOR INVERSION

				pitch_angle += rc.rc.ch[3] / 100;
				if (pitch_angle > UPPER_PITCH_LIMIT){
					pitch_angle = UPPER_PITCH_LIMIT;
				} else if (pitch_angle < LOWER_PITCH_LIMIT){
					pitch_angle = LOWER_PITCH_LIMIT;
				}
				ui_interface_apply_value_direct(SELECT_PITCH_ANGLE, pitch_angle);
				ui_interface_apply_value_direct(SELECT_YAW_ANGLE, yaw_angle);
    		}
    	} else if (ui_interface_get_selection() == SELECT_AUTO){
    		//place holder for vj
    		if (true){
    			// read from the preset values
    			yaw_angle = PRESET_YAW_ANGLE;
    			pitch_angle = PRESET_PITCH_ANGLE;
    		} else {
    			// read from the RPI

    		}
    		ui_interface_apply_value_direct(SELECT_PITCH_ANGLE, pitch_angle);
    		ui_interface_apply_value_direct(SELECT_YAW_ANGLE, yaw_angle);
    	} else {
    		yaw_angle = ui_interface_get_set_yaw();
			pitch_angle = ui_interface_get_set_pitch();
    	}

		/* Get cur values from Sensors */
		// reductiongear ratio is 1:5000 and there is 17 basic pulse per revolution with a 4x ab encoder
		// so 1 revolution = 360 degrees
		// so TIM2->CNT * (360.0f / (17.0f * 4.0f * 5000.0f)) = current pitch angle in degrees
		cur_pitch_deg_angle = TIM2->CNT * (360.0f / (17.0f * 4.0f * 5000.0f)) + LOWER_PITCH_LIMIT;

		dm_motor_t yaw_snap;
		dm_motor_snapshot(&yaw_snap, &dm_yaw_motor);
		// convert the yaw angle from radians to degrees
		float cur_yaw_deg_angle = yaw_snap.para.pos / DEG2RAD;
		ui_interface_update_current_values(cur_pitch_deg_angle, cur_yaw_deg_angle);

		/* Time step for PID (s) */
		TickType_t now = xTaskGetTickCount();
		float dt = (now - last) * portTICK_PERIOD_MS * 0.001f;
		if (dt <= 0.0f) {
			dt = 0.001f;
		}
		last = now;
		/* Single-loop PID: angle (deg) -> torque */
		PID_Compute(&Pitch_PID, pitch_angle, cur_pitch_deg_angle, dt, 0.0f);

		// apply torque command from PID
		Motor_SetTorque(Pitch_PID.output);
		/* Send controls to motors */
		clamp_yaw_sync_ui();
    	dm_yaw_motor.ctrl.pos_set = yaw_angle * DEG2RAD;
        dm_ctrl_send(&hcan1, &dm_yaw_motor);


		#endif
    }

    /* USER CODE END YawTask */
}


static void testing_pitch_n_yaw(void)
{
	dm_motor_t yaw_snap;
	dm_motor_snapshot(&yaw_snap, (const volatile dm_motor_t *)&dm_yaw_motor);
	// Set velocity and direction for the brushed dc motor (pitch motor)
	if (op_sen_yaw_35deg){
		op_sen_yaw_35deg = 0;
		__HAL_TIM_SET_COUNTER(&htim2, 0);
	}

	cur_pitch_deg_angle = TIM2->CNT * (360.0f / (17.0f * 4.0f * 5000.0f)) + LOWER_PITCH_LIMIT;

	RC_ctrl_t rc;
	get_remote_control_snapshot(&rc);
	//turn on controller
	if (rc.rc.s[0] != 1){
		int16_t velocity = rc.rc.ch[3];
		if (velocity == 0){
			Motor_SetDirection(MODE_COASTING);
		}
		else if (velocity > 0){
			Motor_SetDirection(MODE_BACKWARD);

		}
		else {
			// negative velocity
			Motor_SetDirection(MODE_FORWARD);
		}
		Motor_SetPwmCounts(abs(velocity*5));

	// Set Velocity for the brushless motor (yaw motor)

		#if TESTING_YAW_ANGLE == 1
			#if TESTING_ONLY_YAW == 0
				/* Same degree delta as SELECT_RC in PitchnYawTask */
				yaw_angle -= (float)rc.rc.ch[2] / 100.0f;
			#endif
			//NEED TO CHECK FOR INVERSION
			clamp_yaw_sync_ui();
			dm_yaw_motor.ctrl.pos_set = yaw_angle * DEG2RAD;
			dm_yaw_motor.ctrl.vel_set = 0.0f;
			dm_yaw_motor.ctrl.kp_set  =  YAW_KP_SET;
			dm_yaw_motor.ctrl.kd_set  = YAW_KD_SET;
			dm_yaw_motor.ctrl.tor_set = 0.0f;
			dm_ctrl_send(&hcan1, &dm_yaw_motor);
		#else

		yaw_velocity = rc.rc.ch[2] / 5;

		if (yaw_velocity > yaw_threshold_velocity) {
			yaw_velocity = yaw_threshold_velocity;
		}
		else if (yaw_velocity < -yaw_threshold_velocity) {
			yaw_velocity = -yaw_threshold_velocity;
		}

		if ((yaw_snap.para.pos > 1.66995525) && (yaw_snap.para.pos < 2.23408604)){
			dm_yaw_motor.ctrl.vel_set = yaw_velocity;
		} else {
			dm_yaw_motor.ctrl.vel_set = 0;
		}
		dm_ctrl_send(&hcan1, &dm_yaw_motor);
		#endif
	} else {
		// turn off controller
		Motor_SetPwmCounts(0);
		Motor_SetDirection(MODE_COASTING);
		#if TESTING_YAW_ANGLE
			dm_yaw_motor.ctrl.pos_set = yaw_angle * DEG2RAD;
			dm_yaw_motor.ctrl.vel_set = 0.0f;
			dm_yaw_motor.ctrl.kp_set  =  YAW_KP_SET;
			dm_yaw_motor.ctrl.kd_set  = YAW_KD_SET;
			dm_yaw_motor.ctrl.tor_set = 0.0f;
			dm_ctrl_send(&hcan1, &dm_yaw_motor);
		#else
			yaw_velocity = 0;
			dm_yaw_motor.ctrl.vel_set = yaw_velocity;
			dm_ctrl_send(&hcan1, &dm_yaw_motor);
		#endif
	}

	/* Keep UI current pitch/yaw in sync with sensors (same as non-testing loop) */
	dm_motor_snapshot(&yaw_snap, (const volatile dm_motor_t *)&dm_yaw_motor);
	{
		float cur_yaw_deg_angle = yaw_snap.para.pos / DEG2RAD;
		ui_interface_update_current_values(cur_pitch_deg_angle, cur_yaw_deg_angle);
	}
}

static void testing_yaw_screen(void)
{
	dm_motor_t yaw_snap;

	if (op_sen_yaw_35deg) {
		op_sen_yaw_35deg = 0;
		__HAL_TIM_SET_COUNTER(&htim2, 0);
	}

	cur_pitch_deg_angle = TIM2->CNT * (360.0f / (17.0f * 4.0f * 5000.0f)) + LOWER_PITCH_LIMIT;

	yaw_angle = ui_interface_get_set_yaw();
	clamp_yaw_sync_ui();

	Motor_SetTorque(0.0f);

	dm_yaw_motor.ctrl.pos_set = yaw_angle * DEG2RAD;
	dm_yaw_motor.ctrl.vel_set = 0.0f;
	dm_yaw_motor.ctrl.kp_set = YAW_KP_SET;
	dm_yaw_motor.ctrl.kd_set = YAW_KD_SET;
	dm_yaw_motor.ctrl.tor_set = 0.0f;
	dm_ctrl_send(&hcan1, &dm_yaw_motor);

	dm_motor_snapshot(&yaw_snap, (const volatile dm_motor_t *)&dm_yaw_motor);
	{
		float cur_yaw_deg_angle = yaw_snap.para.pos / DEG2RAD;
		ui_interface_update_current_values(cur_pitch_deg_angle, cur_yaw_deg_angle);
	}
}

static void testing_pitch_screen(void)
{
	dm_motor_t yaw_snap;
	static TickType_t last = 0;

	if (op_sen_yaw_35deg) {
		op_sen_yaw_35deg = 0;
		__HAL_TIM_SET_COUNTER(&htim2, 0);
	}

	cur_pitch_deg_angle = TIM2->CNT * (360.0f / (17.0f * 4.0f * 5000.0f)) + LOWER_PITCH_LIMIT;

	pitch_angle = ui_interface_get_set_pitch();
	{
		float p_prev = pitch_angle;
		if (pitch_angle > UPPER_PITCH_LIMIT) {
			pitch_angle = UPPER_PITCH_LIMIT;
		} else if (pitch_angle < LOWER_PITCH_LIMIT) {
			pitch_angle = LOWER_PITCH_LIMIT;
		}
		if (fabsf(pitch_angle - p_prev) > 1e-3f) {
			ui_interface_apply_value_direct(SELECT_PITCH_ANGLE, pitch_angle);
		}
	}

	TickType_t now = xTaskGetTickCount();
	float dt = (now - last) * portTICK_PERIOD_MS * 0.001f;
	if (dt <= 0.0f) {
		dt = 0.001f;
	}
	last = now;
	PID_Compute(&Pitch_PID, pitch_angle, cur_pitch_deg_angle, dt, 0.0f);
	Motor_SetTorque(Pitch_PID.output);

	dm_motor_snapshot(&yaw_snap, (const volatile dm_motor_t *)&dm_yaw_motor);
	dm_yaw_motor.ctrl.pos_set = yaw_snap.para.pos;
	dm_yaw_motor.ctrl.vel_set = 0.0f;
	dm_yaw_motor.ctrl.kp_set = YAW_KP_SET;
	dm_yaw_motor.ctrl.kd_set = YAW_KD_SET;
	dm_yaw_motor.ctrl.tor_set = 0.0f;
	dm_ctrl_send(&hcan1, &dm_yaw_motor);

	dm_motor_snapshot(&yaw_snap, (const volatile dm_motor_t *)&dm_yaw_motor);
	{
		float cur_yaw_deg_angle = yaw_snap.para.pos / DEG2RAD;
		ui_interface_update_current_values(cur_pitch_deg_angle, cur_yaw_deg_angle);
	}
}
