nusrobomaster/Dart-FYP/Implement_pitch_yaw_feeder/Core/Src/UI/ui.c

#if defined(EEZ_FOR_LVGL)
#include <eez/core/vars.h>
#endif

#include "ui.h"
#include "screens.h"
#include "images.h"
#include "actions.h"
#include "vars.h"

// ASSETS DEFINITION
const uint8_t assets[2324] = {
    0x7E, 0x45, 0x45, 0x5A, 0x03, 0x00, 0x06, 0x00, 0x00, 0x00, 0x00, 0x00, 0x24, 0x00, 0x00, 0x00,
    0x24, 0x00, 0x00, 0x00, 0x00, 0x00, 0x00, 0x00, 0x00, 0x00, 0x00, 0x00, 0x00, 0x00, 0x00, 0x00,
    0x00, 0x00, 0x00, 0x00, 0x20, 0x00, 0x00, 0x00, 0x00, 0x00, 0x00, 0x00, 0x00, 0x00, 0x00, 0x00,
    0xE0, 0x01, 0x40, 0x01, 0x01, 0x00, 0x00, 0x00, 0x24, 0x00, 0x00, 0x00, 0x02, 0x00, 0x00, 0x00,
    0x20, 0x00, 0x00, 0x00, 0x01, 0x00, 0x00, 0x00, 0x1C, 0x00, 0x00, 0x00, 0x0F, 0x00, 0x00, 0x00,
    0x04, 0x07, 0x00, 0x00, 0x0C, 0x00, 0x00, 0x00, 0x10, 0x00, 0x00, 0x00, 0x3C, 0x00, 0x00, 0x00,
    0x00, 0x00, 0xFF, 0xFF, 0x40, 0x00, 0x00, 0x00, 0x6C, 0x00, 0x00, 0x00, 0x78, 0x00, 0x00, 0x00,
    0x84, 0x00, 0x00, 0x00, 0x90, 0x00, 0x00, 0x00, 0x9C, 0x00, 0x00, 0x00, 0xA8, 0x00, 0x00, 0x00,
    0xB4, 0x00, 0x00, 0x00, 0xC0, 0x00, 0x00, 0x00, 0xCC, 0x00, 0x00, 0x00, 0xD8, 0x00, 0x00, 0x00,
    0xE4, 0x00, 0x00, 0x00, 0xF0, 0x00, 0x00, 0x00, 0xFC, 0x00, 0x00, 0x00, 0x00, 0x00, 0x00, 0x00,
    0x00, 0x00, 0x00, 0x00, 0x12, 0x00, 0x00, 0x00, 0xF4, 0x00, 0x00, 0x00, 0x00, 0x00, 0x00, 0x00,
    0x00, 0x00, 0x00, 0x00, 0x01, 0x00, 0x00, 0x00, 0xD8, 0x06, 0x00, 0x00, 0x00, 0x00, 0x00, 0x00,
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
    lv_obj_t *screen = getLvglObjectFromIndex(currentScreen);
    lv_scr_load_anim(screen, LV_SCR_LOAD_ANIM_FADE_IN, 200, 0, false);
}

void ui_init() {
    create_screens();
    loadScreen(SCREEN_ID_YAW);

}

void ui_tick() {
    tick_screen(currentScreen);
}

#endif
