nusrobomaster/Dart-FYP/Implement_pitch_yaw_feeder/Core/Src/ui_interface.c

/*
 * ui_interface.c
 *
 * Interface between UI and subsystem tasks (pitch, yaw, launcher, feeder)
 *
 * Created on: Jan 21, 2026
 */

#include "ui_interface.h"
#include "UI/screens.h"
#include "UI/vars.h"
#include "UI/ui.h"
#include "Tasks/pitchnyawTask.h"
#include <stdbool.h>
#include <string.h>
#include <stdlib.h>
#include <stdio.h>

/* Global UI control state */
ui_control_state_t ui_state = {0};

#define UI_ERROR_TEXT_COMPONENT_INDEX 16u
#define UI_ERROR_TEXT_PROPERTY_INDEX 3u
#define UI_ERROR_CLEAR_MS 10000u

static char s_error_text[128];
static uint32_t s_error_set_tick_ms;
static bool s_error_active;

static void ui_interface_publish_error_text(const char *text)
{
    void *flowState = getFlowState(0, 0);
    if (flowState == NULL) {
        return;
    }

    assignStringProperty(
        flowState,
        UI_ERROR_TEXT_COMPONENT_INDEX,
        UI_ERROR_TEXT_PROPERTY_INDEX,
        text != NULL ? text : "",
        "Failed to assign Error Text label"
    );
}

/* ========================= Initialization ========================= */

void ui_interface_init(void)
{
    ui_state.selection_mode = SELECT_NONE;
    ui_state.set_pitch_angle = 0.0f;
    ui_state.set_yaw_angle = 0.0f;
    ui_state.set_launcher_force = 0.0f;
    ui_state.current_pitch_angle = 0.0f;
    ui_state.current_yaw_angle = 0.0f;
    ui_state.feeder_reload_request = false;
    ui_state.values_updated = false;
    ui_state.fire_request = false;
    ui_state.draw_request = false;
    ui_state.firing = false;
    ui_state.auto_dart_count = 0;

    s_error_text[0] = '\0';
    s_error_set_tick_ms = 0;
    s_error_active = false;
}

/* ========================= Native variable: firing ========================= */

bool get_var_firing(void)
{
    return ui_state.firing;
}

void set_var_firing(bool value)
{
    ui_state.firing = value;
}

void ui_interface_set_firing(bool firing)
{
    ui_state.firing = firing;
}

bool ui_interface_get_firing(void)
{
    return ui_state.firing;
}

/* ========================= Auto page: dart count ========================= */

void ui_interface_set_auto_dart_count(uint8_t count)
{
    if (count >= 0 && count <= 4) {
        ui_state.auto_dart_count = count;
    }
}

uint8_t ui_interface_get_auto_dart_count(void)
{
    return ui_state.auto_dart_count;
}

bool ui_interface_check_draw_request(void)
{
    if (ui_state.draw_request) {
        ui_state.draw_request = false;
        return true;
    }
    return false;
}

void ui_interface_trigger_draw(void)
{
    ui_state.draw_request = true;
}

void ui_interface_trigger_fire(void)
{
    ui_state.fire_request = true;
}

bool ui_interface_check_fire_request(void)
{
	if (ui_state.fire_request) {
	        ui_state.fire_request = false;
	        return true;
	    }
	 return false;
}
/* ========================= Selection Mode ========================= */

void ui_interface_set_selection(ui_selection_mode_t mode)
{
    ui_state.selection_mode = mode;
}

ui_selection_mode_t ui_interface_get_selection(void)
{
    return ui_state.selection_mode;
}

/* ========================= Value Application ========================= */

void ui_interface_apply_value(void)
{
    /* This function is kept for compatibility but 
       the main logic is now in ui_interface_apply_value_direct */
}

void ui_interface_apply_value_direct(ui_selection_mode_t mode, float value)
{
    switch (mode) {
        case SELECT_PITCH_ANGLE:
            ui_state.set_pitch_angle = value;
            ui_state.values_updated = true;
            break;
        case SELECT_YAW_ANGLE:
            ui_state.set_yaw_angle = value;
            ui_state.values_updated = true;
            break;
        case SELECT_LAUNCHER_FORCE:
            ui_state.set_launcher_force = value;
            ui_state.values_updated = true;
            break;
        case SELECT_AUTO: {
            /* Same numpad + OK as force/pitch/yaw: value = number of darts (1..9) */
            int n = (int)(value + 0.5f);
            if (n < 1) n = 1;
            if (n > 4) n = 4;
            ui_state.auto_dart_count = (uint8_t)n;
            ui_state.values_updated = true;
            break;
        }
        case SELECT_RC:
            break;
        default:
            /* No selection - don't apply */
            break;
    }
    
    /* Update display to show new set values */
    ui_interface_update_display();
}

bool ui_interface_apply_value_validated(ui_selection_mode_t mode, float value)
{
    if (mode == SELECT_PITCH_ANGLE) {
        if (value < LOWER_PITCH_LIMIT || value > UPPER_PITCH_LIMIT) {
            char msg[96];
            snprintf(
                msg,
                sizeof(msg),
                "Pitch out of range (%.1f..%.1f)",
                (double)LOWER_PITCH_LIMIT,
                (double)UPPER_PITCH_LIMIT
            );
            ui_interface_set_error(msg);
            return false;
        }
    } else if (mode == SELECT_YAW_ANGLE) {
        const float left_limit_deg = LEFT_YAW_LIMIT_DEG;
        const float right_limit_deg = RIGHT_YAW_LIMIT_DEG;
        const float yaw_min_deg = (left_limit_deg < right_limit_deg) ? left_limit_deg : right_limit_deg;
        const float yaw_max_deg = (left_limit_deg > right_limit_deg) ? left_limit_deg : right_limit_deg;
        if (value < yaw_min_deg || value > yaw_max_deg) {
            char msg[96];
            snprintf(
                msg,
                sizeof(msg),
                "Yaw out of range (%.2f..%.2f deg)",
                (double)yaw_min_deg,
                (double)yaw_max_deg
            );
            ui_interface_set_error(msg);
            return false;
        }
    }

    ui_interface_apply_value_direct(mode, value);
    ui_interface_clear_error();
    return true;
}

void ui_interface_set_error(const char *msg)
{
    if (msg == NULL || msg[0] == '\0') {
        ui_interface_clear_error();
        return;
    }

    strncpy(s_error_text, msg, sizeof(s_error_text) - 1);
    s_error_text[sizeof(s_error_text) - 1] = '\0';
    s_error_active = true;
    s_error_set_tick_ms = lv_tick_get();
    ui_interface_publish_error_text(s_error_text);
}

void ui_interface_clear_error(void)
{
    s_error_text[0] = '\0';
    s_error_active = false;
    ui_interface_publish_error_text("");
}

void ui_interface_error_tick(uint32_t now_ms)
{
    if (!s_error_active) {
        return;
    }

    if ((uint32_t)(now_ms - s_error_set_tick_ms) >= UI_ERROR_CLEAR_MS) {
        ui_interface_clear_error();
    }
}

/* ========================= Feeder Reload ========================= */

void ui_interface_trigger_reload(void)
{
    ui_state.feeder_reload_request = true;
}

bool ui_interface_check_reload_request(void)
{
    if (ui_state.feeder_reload_request) {
        ui_state.feeder_reload_request = false;
        return true;
    }
    return false;
}

/* ========================= Value Getters ========================= */

void ui_interface_update_current_values(float pitch_angle, float yaw_angle)
{
    ui_state.current_pitch_angle = pitch_angle;
    ui_state.current_yaw_angle = yaw_angle;
}

float ui_interface_get_set_pitch(void)
{
    return ui_state.set_pitch_angle;
}

float ui_interface_get_set_yaw(void)
{
    return ui_state.set_yaw_angle;
}

float ui_interface_get_set_force(void)
{
    return ui_state.set_launcher_force;
}

/* ========================= Display Update ========================= */

void ui_interface_update_display(void)
{
    char buf[64];
    
    /* Update YAW labels */
    if (objects.yaw_set != NULL) {
        snprintf(buf, sizeof(buf), "Set Yaw Angle: \n%.2f", ui_state.set_yaw_angle);
        lv_label_set_text(objects.yaw_set, buf);
    }

    if (objects.yaw_cu != NULL) {
        snprintf(buf, sizeof(buf), "Current Yaw Angle: \n%.2f", ui_state.current_yaw_angle);
        lv_label_set_text(objects.yaw_cu, buf);
    }
    if (objects.yaw_cu_1 != NULL){
    	snprintf(buf, sizeof(buf), "Current Yaw Angle: \n%.2f", ui_state.current_yaw_angle);
    	lv_label_set_text(objects.yaw_cu_1, buf);
    }
    /* Update PITCH labels */
    if (objects.pitch_set != NULL) {
        snprintf(buf, sizeof(buf), "Set Pitch Angle: \n%.2f", ui_state.set_pitch_angle);
        lv_label_set_text(objects.pitch_set, buf);
    }

    if (objects.pitch_cur != NULL) {
        snprintf(buf, sizeof(buf), "Current Pitch Angle: \n%.2f", ui_state.current_pitch_angle);
        lv_label_set_text(objects.pitch_cur, buf);
    }

    if (objects.pitch_cur_1 != NULL) {
        snprintf(buf, sizeof(buf), "Current Pitch Angle: \n%.2f", ui_state.current_pitch_angle);
        lv_label_set_text(objects.pitch_cur_1, buf);
    }

    /* Update LAUNCHER labels */
    if (objects.launcher_set != NULL) {
        snprintf(buf, sizeof(buf), "Set Launcher Force: \n%.2f", ui_state.set_launcher_force);
        lv_label_set_text(objects.launcher_set, buf);
    }

    if (objects.launcher_cur != NULL) {
        snprintf(buf, sizeof(buf), "Current Launcher Force: \n%.2f", ui_state.current_launcher_force);
        lv_label_set_text(objects.launcher_cur, buf);
    }

    if (objects.launcher_cur_1 != NULL) {
        snprintf(buf, sizeof(buf), "Current Launcher Force: \n%.2f", ui_state.current_launcher_force);
        lv_label_set_text(objects.launcher_cur_1, buf);
    }
}

/* ========================= Deprecated Functions ========================= */
/* These are kept for backward compatibility but may not be used */

void ui_interface_numpad_press(const char *btn_text)
{
    (void)btn_text;
    /* Number pad handling is now done in actions.c action_button_mat() */
}

void ui_interface_update_button_styles(void)
{
    /* Button styles are handled by page selection now */
}

const char* ui_interface_get_input_text(void)
{
    if (objects.yaw_text_area == NULL) {
        return "";
    }
    return lv_textarea_get_text(objects.yaw_text_area);
}

void ui_interface_clear_input(void)
{
    if (objects.yaw_text_area == NULL) {
        return;
    }
    lv_textarea_set_text(objects.yaw_text_area, "");
}
