nusrobomaster/Dart-FYP/Implement_pitch_yaw_feeder/Core/Src/UI/ui.h

#ifndef EEZ_LVGL_UI_GUI_H
#define EEZ_LVGL_UI_GUI_H

#include <lvgl.h>

#include "../eez-flow.h"

#if !defined(EEZ_FOR_LVGL)
#include "screens.h"
#endif

#ifdef __cplusplus
extern "C" {
#endif

extern const uint8_t assets[2324];

void ui_init();
void ui_tick();

#if !defined(EEZ_FOR_LVGL)
void loadScreen(enum ScreensEnum screenId);
#endif

#ifdef __cplusplus
}
#endif

#endif // EEZ_LVGL_UI_GUI_H
