nusrobomaster/Dart-FYP/test_rc/Core/Src/LCD_CAP/TOUCH/ft6336.c

//////////////////////////////////////////////////////////////////////////////////	 

















//All rights reserved
/****************************************************************************************************
/****************************************************************************************************























**************************************************************************************************/	
 /* @attention
  *
  * THE PRESENT FIRMWARE WHICH IS FOR GUIDANCE ONLY AIMS AT PROVIDING CUSTOMERS
  * WITH CODING INFORMATION REGARDING THEIR PRODUCTS IN ORDER FOR THEM TO SAVE
  * TIME. AS A RESULT, QD electronic SHALL NOT BE HELD LIABLE FOR ANY
  * DIRECT, INDIRECT OR CONSEQUENTIAL DAMAGES WITH RESPECT TO ANY CLAIMS ARISING
  * FROM THE CONTENT OF SUCH FIRMWARE AND/OR THE USE MADE BY CUSTOMERS OF THE
  * CODING INFORMATION CONTAINED HEREIN IN CONNECTION WITH THEIR PRODUCTS.
**************************************************************************************************/
#include "ft6336.h"
#include "touch.h"
#include "delay.h" 
#include "string.h" 
#include "../LCD/lcd.h"

extern volatile uint8_t touch_flag;
#define FT6336_I2C_ADDR (0x38 << 1)
#define FT6336_I2C_TIMEOUT 100
extern I2C_HandleTypeDef hi2c2;

/*****************************************************************************
 * @name       :u8 FT5426_WR_Reg(u16 reg,u8 *buf,u8 len)
 * @date       :2020-05-13 
 * @function   :Write data to ft5426 once
 * @parameters :reg:Start register address for written
								buf:the buffer of data written
								len:Length of data written
 * @retvalue   :0-Write succeeded 
								1-Write failed
******************************************************************************/ 
u8 FT6336_WR_Reg(u16 reg,u8 *buf,u8 len)
{
    if (HAL_I2C_Mem_Write(&hi2c2, FT6336_I2C_ADDR, reg, I2C_MEMADD_SIZE_8BIT,
                          buf, len, FT6336_I2C_TIMEOUT) == HAL_OK) {
        return 0;
    }
    return 1;
}

/*****************************************************************************
 * @name       :void FT5426_RD_Reg(u16 reg,u8 *buf,u8 len)
 * @date       :2020-05-13 
 * @function   :Read data to ft5426 once
 * @parameters :reg:Start register address for read
								buf:the buffer of data read
								len:Length of data read
 * @retvalue   :none
******************************************************************************/			  
void FT6336_RD_Reg(u16 reg,u8 *buf,u8 len)
{
    (void)HAL_I2C_Mem_Read(&hi2c2, FT6336_I2C_ADDR, reg, I2C_MEMADD_SIZE_8BIT,
                          buf, len, FT6336_I2C_TIMEOUT);
} 

/*****************************************************************************
 * @name       :u8 FT5426_Init(void)
 * @date       :2020-05-13 
 * @function   :Initialize the ft5426 touch screen
 * @parameters :none
 * @retvalue   :0-Initialization successful
								1-initialization failed
******************************************************************************/		
u8 FT6336_Init(void)
{
	u8 temp[2]; 	
	 GPIO_InitTypeDef  GPIO_InitStructure;

	    __HAL_RCC_GPIOF_CLK_ENABLE();
    __HAL_RCC_GPIOI_CLK_ENABLE();

    GPIO_InitStructure.Pin = GPIO_PIN_9;
    GPIO_InitStructure.Mode = GPIO_MODE_OUTPUT_PP;
    GPIO_InitStructure.Pull = GPIO_NOPULL;
    GPIO_InitStructure.Speed = GPIO_SPEED_FREQ_HIGH;
    HAL_GPIO_Init(GPIOI, &GPIO_InitStructure);

    FT_RST(0);
	delay_ms(10);
 	FT_RST(1);
	delay_ms(500);  	
//	temp[0]=0;




	FT6336_RD_Reg(FT_ID_G_FOCALTECH_ID,&temp[0],1);
	if(temp[0]!=0x11)
	{
		return 1;
	}
	FT6336_RD_Reg(FT_ID_G_CIPHER_MID,&temp[0],2);
	if(temp[0]!=0x26)
	{
		return 1;
	}
	if((temp[1]!=0x00)&&(temp[1]!=0x01)&&(temp[1]!=0x02))
	{
		return 1;
	}
	FT6336_RD_Reg(FT_ID_G_CIPHER_HIGH,&temp[0],1);
	if(temp[0]!=0x64)
	{
		return 1;
	}

//	FT6336_WR_Reg(FT_ID_G_PERIODACTIVE,temp,1); 

//	FT6336_RD_Reg(FT_ID_G_LIB_VERSION,&temp[0],2);  

//	{ 
//		printf("CTP ID:%x\r\n",((u16)temp[0]<<8)+temp[1]);
//		return 0;
//	} 
	return 0;
}

const u16 FT6336_TPX_TBL[2]={FT_TP1_REG,FT_TP2_REG};

/*****************************************************************************
 * @name       :u8 FT5426_Scan(void)
 * @date       :2020-05-13 
 * @function   :Scan touch screen (query mode)
 * @parameters :none
 * @retvalue   :Current touch screen status
								0-No touch
								1-With touch
******************************************************************************/	
u8 FT6336_Scan(void)
{
	u8 buf[4];
	u8 i=0;
	u8 res=0;
	u8 temp;
	u8 mode;
	static u8 t=0;
	if ((touch_flag == 0U) && (FT_INT != GPIO_PIN_RESET) && ((tp_dev.sta & TP_PRES_DOWN) == 0U)) {
		return 0;
	}
	touch_flag = 0U;
	t++;
	if ((t % 10U) == 0U || t < 10U || (tp_dev.sta & TP_PRES_DOWN))
	{
		FT6336_RD_Reg(FT_REG_NUM_FINGER,&mode,1);
		if(mode&&(mode<3))
		{
			temp=0XFF<<mode;
			tp_dev.sta=(~temp)|TP_PRES_DOWN|TP_CATH_PRES; 
			for(i=0;i<CTP_MAX_TOUCH;i++)
			{
				FT6336_RD_Reg(FT6336_TPX_TBL[i],buf,4);
				if(tp_dev.sta&(1<<i))
				{
					switch(lcddev.dir)
					{
						case 0:
							tp_dev.x[i]=((u16)(buf[0]&0X0F)<<8)+buf[1];
							tp_dev.y[i]=((u16)(buf[2]&0X0F)<<8)+buf[3];						
							break;
						case 1:
							tp_dev.y[i]=lcddev.height-(((u16)(buf[0]&0X0F)<<8)+buf[1]);
							tp_dev.x[i]=((u16)(buf[2]&0X0F)<<8)+buf[3];						
							break;
						case 2:
							tp_dev.x[i]=lcddev.width-(((u16)(buf[0]&0X0F)<<8)+buf[1]);
							tp_dev.y[i]=lcddev.height-(((u16)(buf[2]&0X0F)<<8)+buf[3]);								
							break;
						case 3:
							tp_dev.y[i]=((u16)(buf[0]&0X0F)<<8)+buf[1];
							tp_dev.x[i]=lcddev.width-(((u16)(buf[2]&0X0F)<<8)+buf[3]);	
							break;
					} 

					//printf("x[%d]:%d,y[%d]:%d\r\n",i,tp_dev.x[i],i,tp_dev.y[i]);
				}			
			} 
			res=1;
			if(tp_dev.x[0]==0 && tp_dev.y[0]==0)mode=0;
			t=0;
		}
	}
	if(mode==0)
	{ 
		if(tp_dev.sta&TP_PRES_DOWN)
		{
			tp_dev.sta&=~(1<<7);
		}else
		{ 
			tp_dev.x[0]=0xffff;
			tp_dev.y[0]=0xffff;
			tp_dev.sta&=0XE0;
		}	 
	} 
	if(t>240)t=10;
	return res;
}
 
