nusrobomaster/Dart-FYP/Implement_pitch_yaw_feeder/Core/Src/UI/styles.h

#ifndef EEZ_LVGL_UI_STYLES_H
#define EEZ_LVGL_UI_STYLES_H

#include <lvgl.h>

#ifdef __cplusplus
extern "C" {
#endif

// Style: red
lv_style_t *get_style_red_MAIN_DEFAULT();
void add_style_red(lv_obj_t *obj);
void remove_style_red(lv_obj_t *obj);



#ifdef __cplusplus
}
#endif

#endif /*EEZ_LVGL_UI_STYLES_H*/
