nusrobomaster/Dart-FYP/Implement_pitch_yaw_feeder/Core/Src/UI/actions.h

#ifndef EEZ_LVGL_UI_EVENTS_H
#define EEZ_LVGL_UI_EVENTS_H

#include <lvgl.h>

#ifdef __cplusplus
extern "C" {
#endif

extern void action_button_mat(lv_event_t * e);


#ifdef __cplusplus
}
#endif

#endif /*EEZ_LVGL_UI_EVENTS_H*/
