nusrobomaster/Dart-FYP/test_rc/Core/Inc/sys.h

#ifndef SYS_H
#define SYS_H

#include "stm32f4xx_hal.h"
#include <stdint.h>

typedef uint8_t  u8;
typedef uint16_t u16;
typedef uint32_t u32;
typedef uint64_t u64;

typedef int8_t  s8;
typedef int16_t s16;
typedef int32_t s32;
typedef int64_t s64;

#endif
