nusrobomaster/Dart-FYP/test_rc/Core/Src/bsp_rc.c

#include "bsp_rc.h"
#include "main.h"

extern UART_HandleTypeDef huart1;
extern DMA_HandleTypeDef hdma_usart1_rx;

void RC_init(uint8_t *rx1_buf, uint8_t *rx2_buf, uint16_t dma_buf_num)
{
    //enable the DMA transfer for the receiver request
    //使能DMA串口接收
    SET_BIT(huart1.Instance->CR3, USART_CR3_DMAR);

    //enalbe idle interrupt
    //使能空闲中断
    __HAL_UART_ENABLE_IT(&huart1, UART_IT_IDLE);

    //disable DMA
    //失效DMA
    __HAL_DMA_DISABLE(&hdma_usart1_rx);
    while(hdma_usart1_rx.Instance->CR & DMA_SxCR_EN)
    {
        __HAL_DMA_DISABLE(&hdma_usart1_rx);
    }

    hdma_usart1_rx.Instance->PAR = (uint32_t) & (USART1->DR);
    //memory buffer 1
    //内存缓冲区1
    hdma_usart1_rx.Instance->M0AR = (uint32_t)(rx1_buf);
    //memory buffer 2
    //内存缓冲区2
    hdma_usart1_rx.Instance->M1AR = (uint32_t)(rx2_buf);
    //data length
    //数据长度
    hdma_usart1_rx.Instance->NDTR = dma_buf_num;
    //enable double memory buffer
    //使能双缓冲区
    SET_BIT(hdma_usart1_rx.Instance->CR, DMA_SxCR_DBM);

    //enable DMA
    //使能DMA
    __HAL_DMA_ENABLE(&hdma_usart1_rx);

}
