nusrobomaster/Dart-FYP/(commit log)

2025-10-14 Implement a screeen view of real life weight sensor data
2025-10-15 implement prototype2
2025-10-15 Implemented the FSM for motor moving
2025-11-13 adding content 1, for dart robot yaw
2025-11-13 adding content 2, for dart robot pitch
2025-11-14 Yeeted all yaw pictures and captions in
2025-12-01 DM motor Dev A
    some how it works
2025-12-03 Fix initialization for damiao motor
    Found out that the intialization is too fast resulting in no enabling of motor
    [main.c]
2025-12-10 test m3508 on dev c
    [dev_c_DAP.cfg]
2025-12-18 Should have split this into multiple commits
    dm motor project has step based rpm change
    test_LVGL now has touch button capability after the inclusion of indef from lvgl documentation
    test_touch was a test code to try out touchgfx incase lvgl did not suceed
2025-12-26 Created prototype 3
    improvement from 2 is the inclusion of lvgl and the new cap touch screen
2025-12-26 Change from rm motor to dm motors
2025-12-28 created prototype4
    plan is to create the structure of the code
2025-12-28 add briteencoder driver
    task in ioc file can be created as weak
2026-01-13 Test servos
2026-01-14 implemented dc motor control
2026-01-16 Test eez studio flow with lvgl
    made changes to prototype 4
2026-01-16 implement correct mapping of position control
    [main.c]
2026-01-20 Flip screen for vertical reading
    [main.c]
2026-01-20 eez studio flow works
2026-01-20 add eez studio flow
2026-01-21 change the structure for code for better integration with eez flow
2026-01-24 Tested optical switch
2026-01-27 fix some issues, implement pitch yaw feeder did not update task properly
    [bsp_damiao.c, launcherTask.c, main.c, test_brushed_dc_motor.ioc]
2026-01-28 clean up code and include #define to ignore ioc file generated uart
2026-02-01 update gitignore to handle kicad
2026-02-05 update gitignore for kicad project
2026-02-05 Add existing kicad file
    [Dart_launcher_robot_pcb.kicad_pcb, Dart_launcher_robot_pcb.kicad_sch, LaunchernFeeder.kicad_sch, Page2.kicad_sch, PitchnYaw.kicad_sch, Power.kicad_sch]
2026-03-05 pcb design and changes to the pitch_yaw_launcher_code
    [Dart_launcher_robot_pcb-B_Mask.gbs, Dart_launcher_robot_pcb-B_Paste.gbp, Dart_launcher_robot_pcb-B_Silkscreen.gbo, Dart_launcher_robot_pcb-Back.gbl, Dart_launcher_robot_pcb-Edge_Cuts.gm1, Dart_launcher_robot_pcb-F_Mask.gts, Dart_launcher_robot_pcb-F_Paste.gtp, Dart_launcher_robot_pcb-F_Silkscreen.gto]
2026-03-12 the launcher task canabalise the feeder task
    update the frequency of the communication to handle longer cable length
    update the pitch yaw to handle control of all the different type of control method
    update screen to have an auto tab and a rc tab
    [LaunchernFeeder.kicad_sch, PitchnYaw.kicad_sch]
2026-03-13 Fix usage of can from different task
    implement turn off controller
    change sequence to handle
    handle interrupr
    [DART_CONFIG.h, bsp_damiao.c, launcherTask.c, launcherTask.h, ptichnyawTask.c]
2026-03-14 fix launcher and pitch and yaw
    [DART_CONFIG.h, Implement_pitch_yaw_feeder.ioc, launcherTask.c, launcherTask.h, main.c, ptichnyawTask.c]
2026-03-14 revert to old remote code
    [remote_control.c]
2026-03-14 handle reading of data from the motor
2026-03-16 tuning pid
2026-04-10 Implement error display for yaw and pitch
    [Dart_launcher_robot_pcb.kicad_pcb]
2026-04-10 yaw control radian yaw read deg
2026-04-12 extra code to test screen with pitch and yaw individually
